MitchellStride/Libraries/KiCAD/µ104_Part_Libs/KiCAD_3D_Parts/SMD_Caps/CAP0805.stp

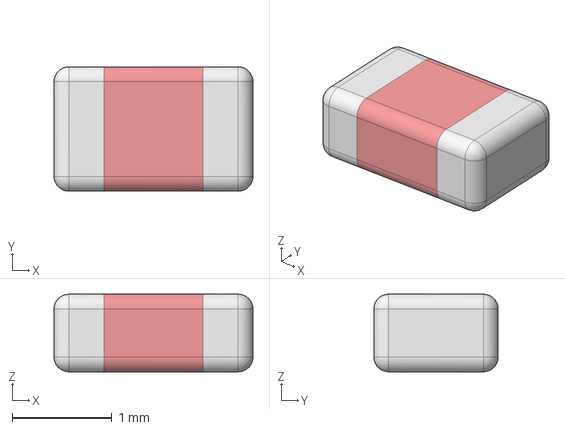
[picture p1: CAD file, 2018-05-30, last stored version]
KiCAD/µ104_Part_Libs/KiCAD_3D_Parts/SMD_Caps/CAP0805.stp
2.00 x 1.25 x 0.78 mm
