MitchellStride/Libraries/KiCAD/µ104_Part_Libs/KiCAD_3D_Parts/µ104KiCAD_3D/Laird-BMI-S-203-F  AND  BMI-S-203-C.step

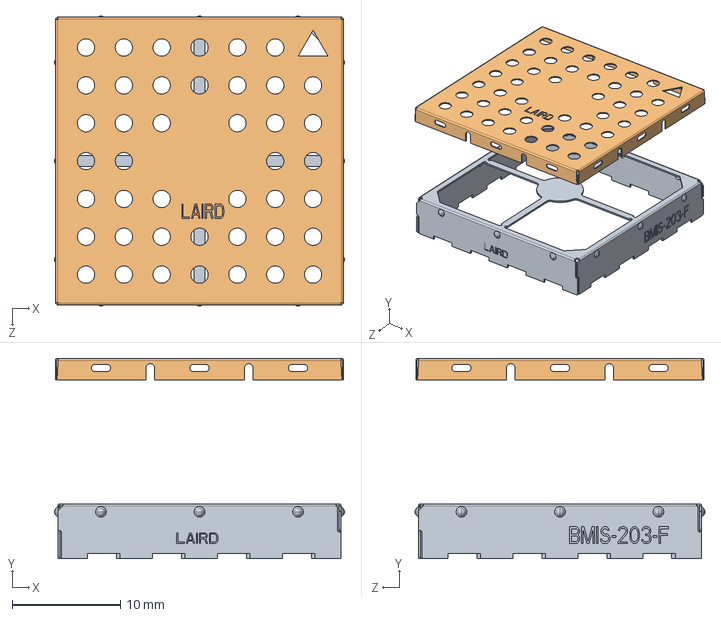
[picture p3: CAD file, 2018-05-30, last stored version]
KiCAD/µ104_Part_Libs/KiCAD_3D_Parts/µ104KiCAD_3D/Laird-BMI-S-203-F AND BMI-S-203-C.step
26.8 x 18.5 x 26.8 mm
Laird-BMI-S-203-F and BMI-S-203-C_BMI-S-203-F
Laird-BMI-S-203-F and BMI-S-203-C_BMI-S-203-C
