MitchellStride/Libraries/KiCAD/µ104_Part_Libs/KiCAD_3D_Parts/µ104KiCAD_connectors_3D/FCI_Minitek_98464-xxx-08xLF.step

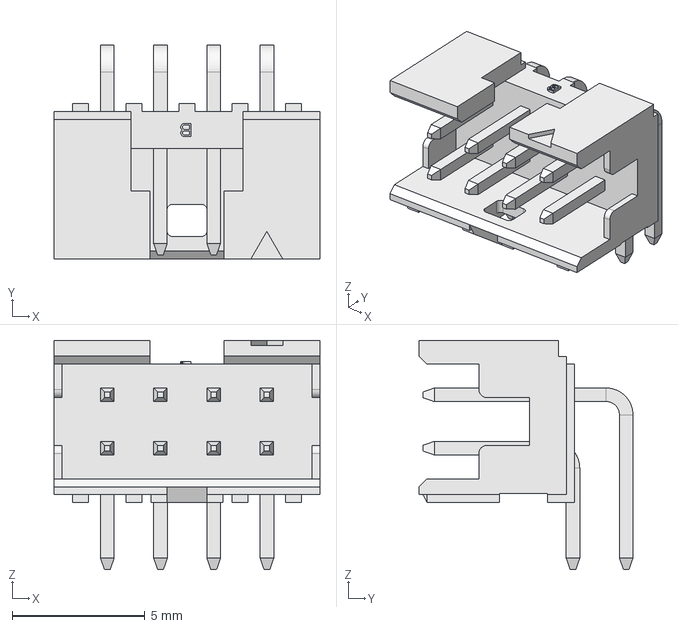
[picture p4: CAD file, 2018-05-30, last stored version]
KiCAD/µ104_Part_Libs/KiCAD_3D_Parts/µ104KiCAD_connectors_3D/FCI_Minitek_98464-xxx-08xLF.step
10.0 x 8.04 x 8.62 mm
