MitchellStride/Libraries/KiCAD/µ104_Part_Libs/KiCAD_3D_Parts/µ104KiCAD_DCDC_3D/VICOR_CHIP3623.STEP

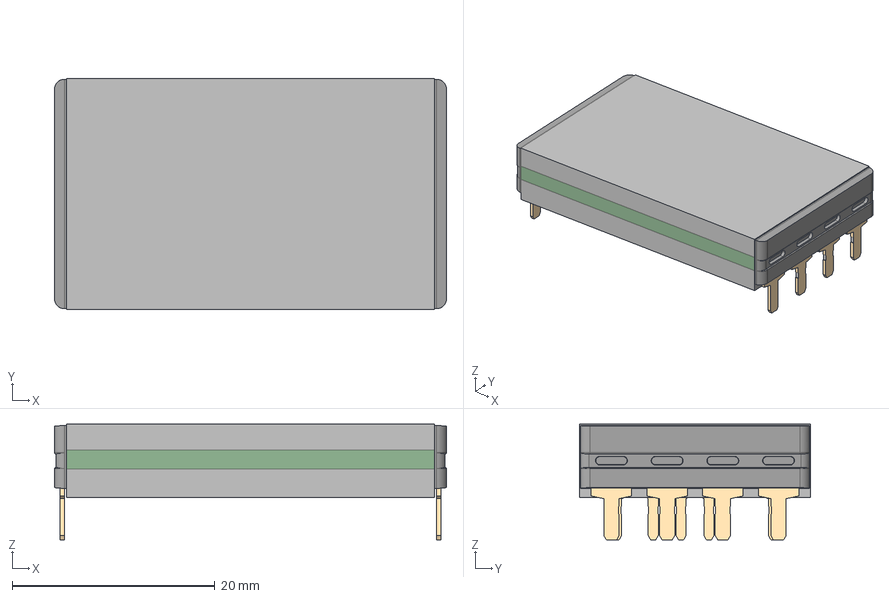
[picture p5: CAD file, 2018-05-30, last stored version]
KiCAD/µ104_Part_Libs/KiCAD_3D_Parts/µ104KiCAD_DCDC_3D/VICOR_CHIP3623.STEP
38.7 x 22.8 x 11.4 mm
