MitchellStride/Libraries/KiCAD/µ104_Part_Libs/KiCAD_3D_Parts/µ104KiCAD_IC_3D/SOD-323.step

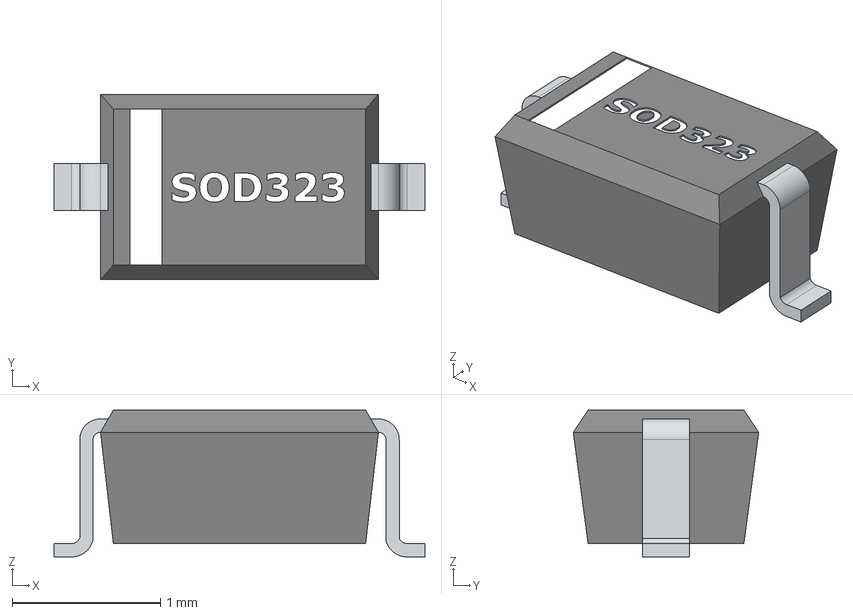
[picture p6: CAD file, 2018-05-30, last stored version]
KiCAD/µ104_Part_Libs/KiCAD_3D_Parts/µ104KiCAD_IC_3D/SOD-323.step
2.50 x 1.25 x 0.99 mm
