MitchellStride/Libraries/KiCAD/µ104_Part_Libs/KiCAD_3D_Parts/µ104KiCAD_relay_3D/Power_DPST_BB_ThruHole_Omron_G6B.step

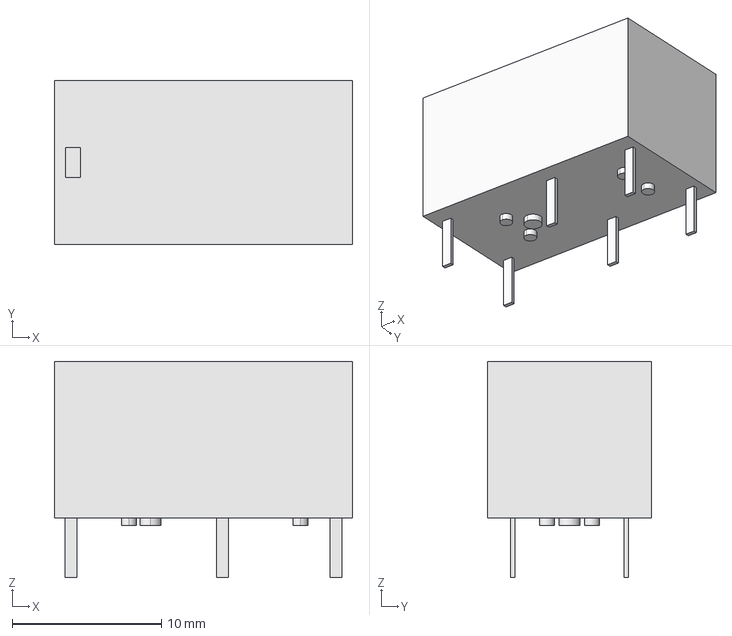
[picture p7: CAD file, 2018-05-30, last stored version]
KiCAD/µ104_Part_Libs/KiCAD_3D_Parts/µ104KiCAD_relay_3D/Power_DPST_BB_ThruHole_Omron_G6B.step
20.0 x 11.0 x 14.5 mm
