MitchellStride/Libraries/KiCAD/µ104_Part_Libs/KiCAD_3D_Parts/µ104KiCAD_RLC_3D/C_Panasonic_EEU-FM-A_D16_H25.step

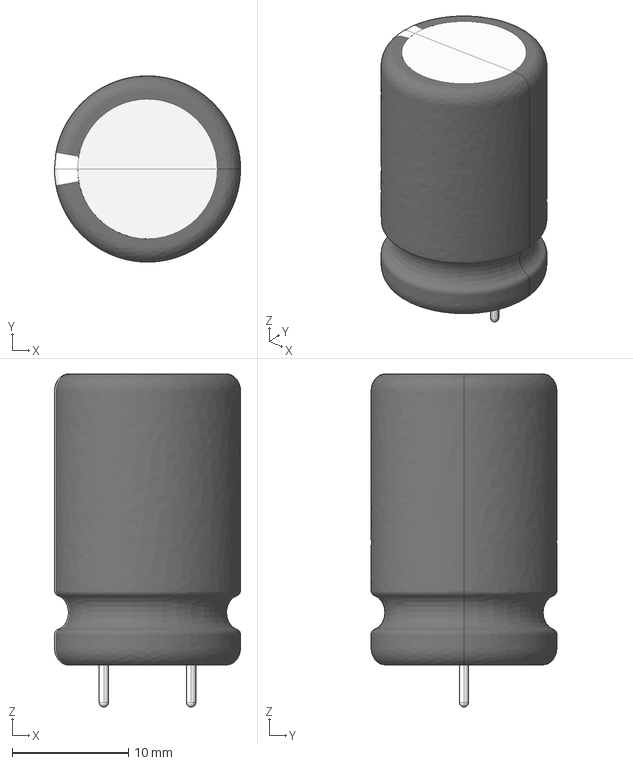
[picture p8: CAD file, 2018-05-30, last stored version]
KiCAD/µ104_Part_Libs/KiCAD_3D_Parts/µ104KiCAD_RLC_3D/C_Panasonic_EEU-FM-A_D16_H25.step
16.0 x 16.0 x 28.6 mm
