MitchellStride/Libraries/KiCAD/µ104_Part_Libs/KiCAD_3D_Parts/SMD_Caps/CAP1206.stp

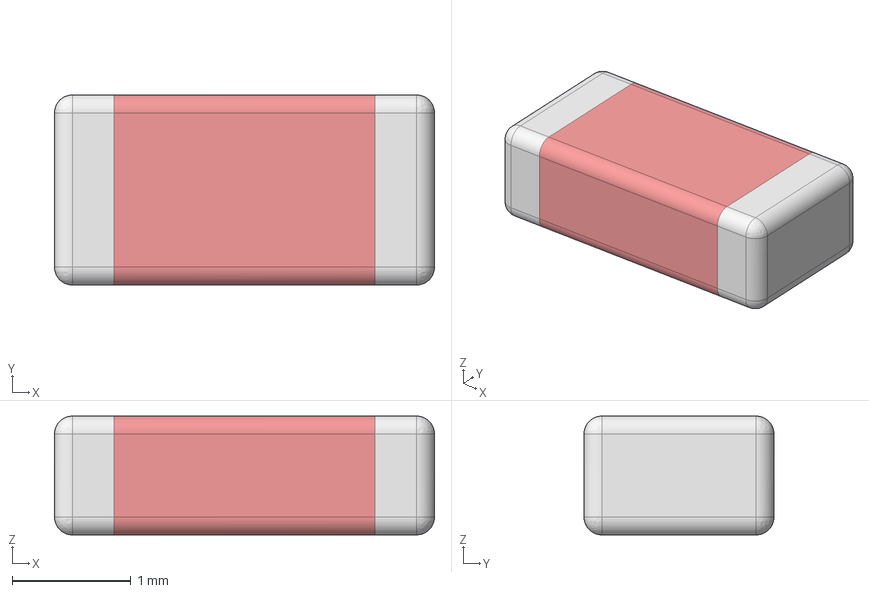
[picture p9: CAD file, 2018-05-30, last stored version]
KiCAD/µ104_Part_Libs/KiCAD_3D_Parts/SMD_Caps/CAP1206.stp
3.20 x 1.60 x 1.00 mm
