MitchellStride/Libraries/KiCAD/µ104_Part_Libs/KiCAD_3D_Parts/SMD_Resistors/RES1218.stp

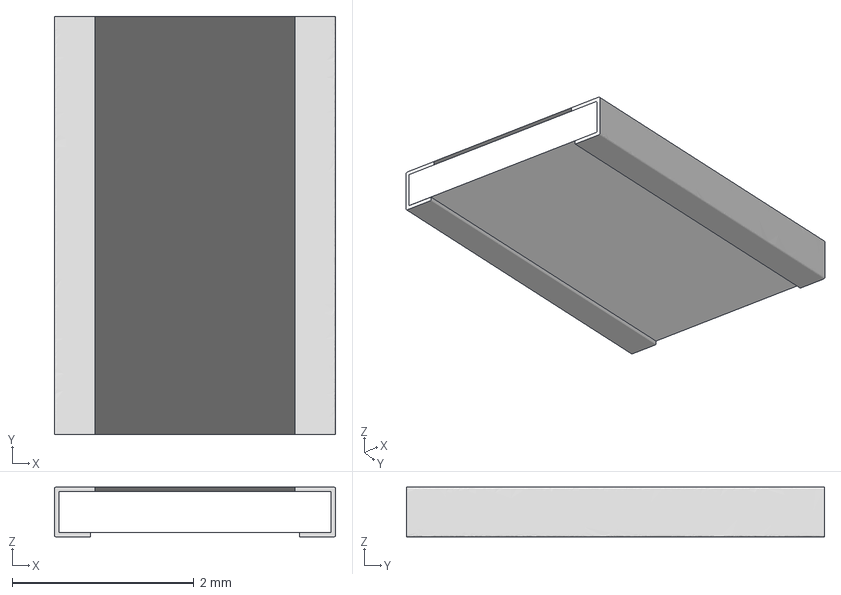
[picture p10: CAD file, 2018-05-30, last stored version]
KiCAD/µ104_Part_Libs/KiCAD_3D_Parts/SMD_Resistors/RES1218.stp
3.10 x 4.61 x 0.55 mm
