MitchellStride/Libraries/KiCAD/µ104_Part_Libs/KiCAD_3D_Parts/µ104KiCAD_3D/SHIELD_Laird_BMI-S-201-F.step

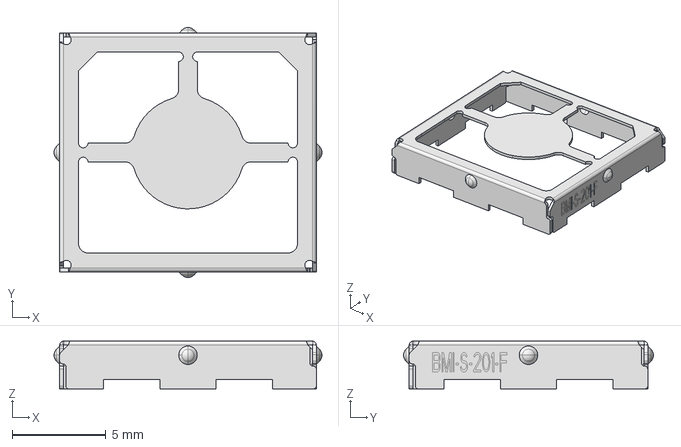
[picture p11: CAD file, 2018-05-30, last stored version]
KiCAD/µ104_Part_Libs/KiCAD_3D_Parts/µ104KiCAD_3D/SHIELD_Laird_BMI-S-201-F.step
14.3 x 13.3 x 2.54 mm
