MitchellStride/Libraries/KiCAD/µ104_Part_Libs/KiCAD_3D_Parts/µ104KiCAD_connectors_3D/Samtec_MTLW-106-07-L-S-280.step

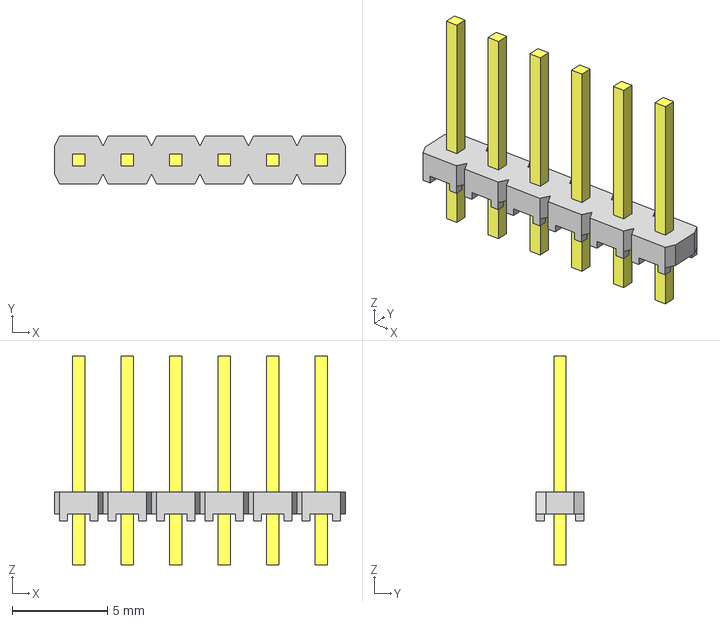
[picture p12: CAD file, 2018-05-30, last stored version]
KiCAD/µ104_Part_Libs/KiCAD_3D_Parts/µ104KiCAD_connectors_3D/Samtec_MTLW-106-07-L-S-280.step
15.2 x 2.49 x 10.9 mm
