MitchellStride/Libraries/KiCAD/µ104_Part_Libs/KiCAD_3D_Parts/µ104KiCAD_DCDC_3D/Murata_OKI-78SR_RA.STEP

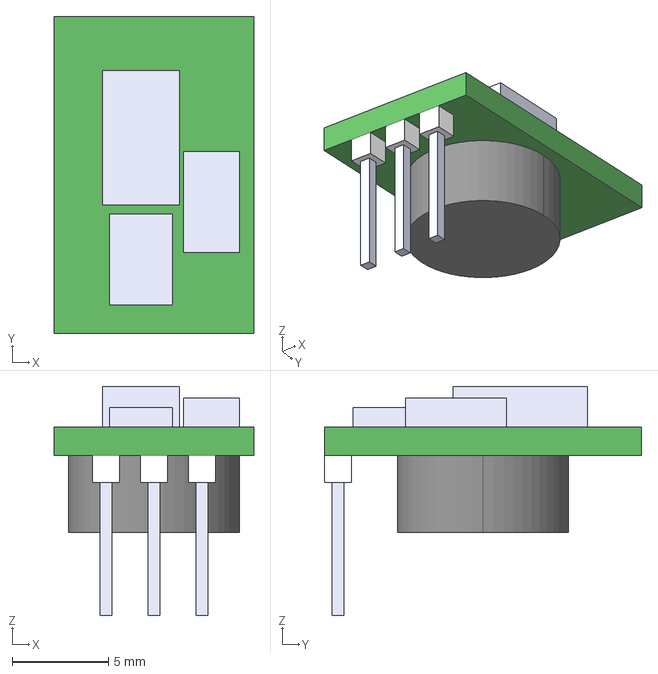
[picture p13: CAD file, 2018-05-30, last stored version]
KiCAD/µ104_Part_Libs/KiCAD_3D_Parts/µ104KiCAD_DCDC_3D/Murata_OKI-78SR_RA.STEP
10.4 x 16.5 x 11.9 mm
