MitchellStride/Libraries/KiCAD/µ104_Part_Libs/KiCAD_3D_Parts/µ104KiCAD_IC_3D/Crystal_L5_W3.2.step

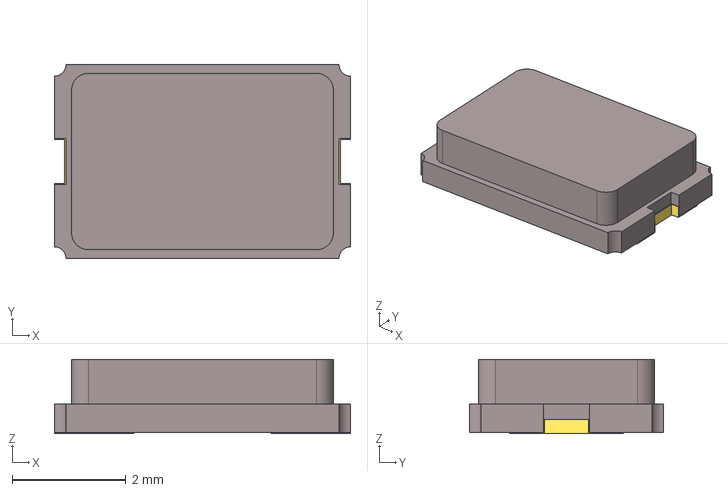
[picture p14: CAD file, 2018-05-30, last stored version]
KiCAD/µ104_Part_Libs/KiCAD_3D_Parts/µ104KiCAD_IC_3D/Crystal_L5_W3.2.step
5.20 x 3.40 x 1.30 mm
