MitchellStride/Libraries/KiCAD/µ104_Part_Libs/KiCAD_3D_Parts/µ104KiCAD_relay_3D/Telecom_DPDT_CC_GullWing_Panasonic_TQ-SMD.step

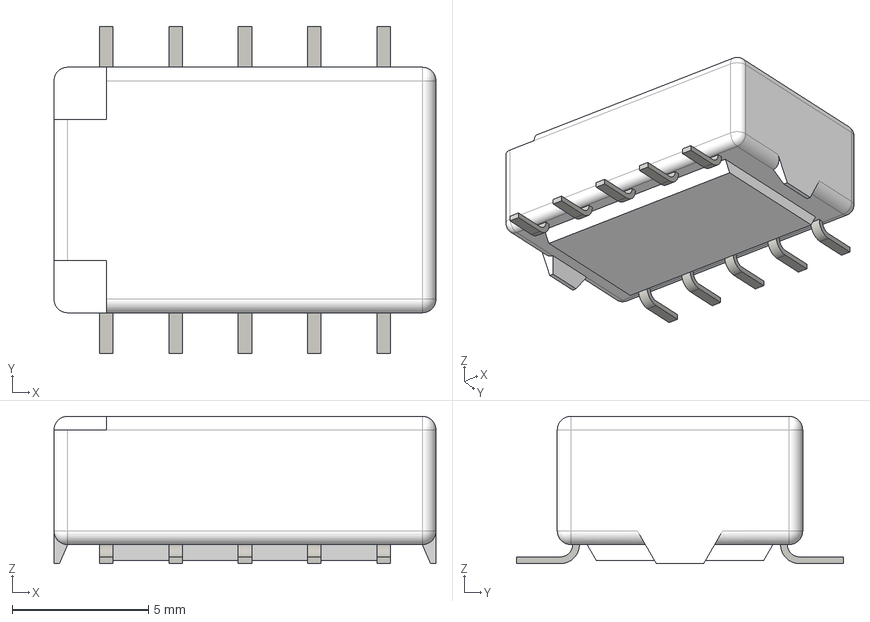
[picture p15: CAD file, 2018-05-30, last stored version]
KiCAD/µ104_Part_Libs/KiCAD_3D_Parts/µ104KiCAD_relay_3D/Telecom_DPDT_CC_GullWing_Panasonic_TQ-SMD.step
14.0 x 12.0 x 5.40 mm
