MitchellStride/Libraries/KiCAD/µ104_Part_Libs/KiCAD_3D_Parts/µ104KiCAD_RLC_3D/C_CDE_SLPX_D35_H35.step

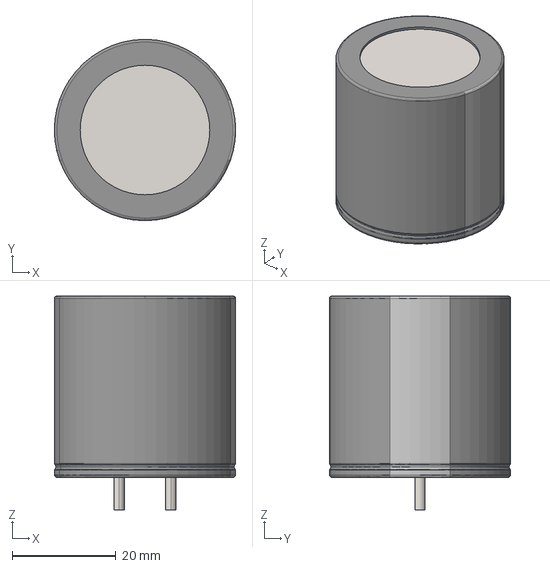
[picture p16: CAD file, 2018-05-30, last stored version]
KiCAD/µ104_Part_Libs/KiCAD_3D_Parts/µ104KiCAD_RLC_3D/C_CDE_SLPX_D35_H35.step
35.0 x 35.0 x 41.3 mm
