MitchellStride/Libraries/KiCAD/µ104_Part_Libs/KiCAD_3D_Parts/SMD_Caps/CAP2220.stp

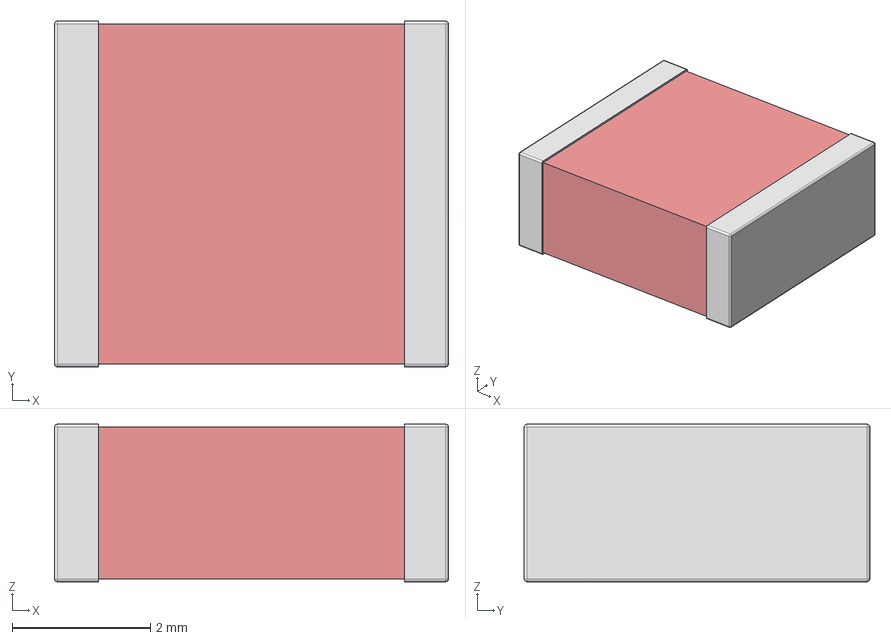
[picture p17: CAD file, 2018-05-30, last stored version]
KiCAD/µ104_Part_Libs/KiCAD_3D_Parts/SMD_Caps/CAP2220.stp
5.70 x 5.00 x 2.28 mm
