MitchellStride/Libraries/KiCAD/µ104_Part_Libs/KiCAD_3D_Parts/SMD_Resistors/RES2010.stp

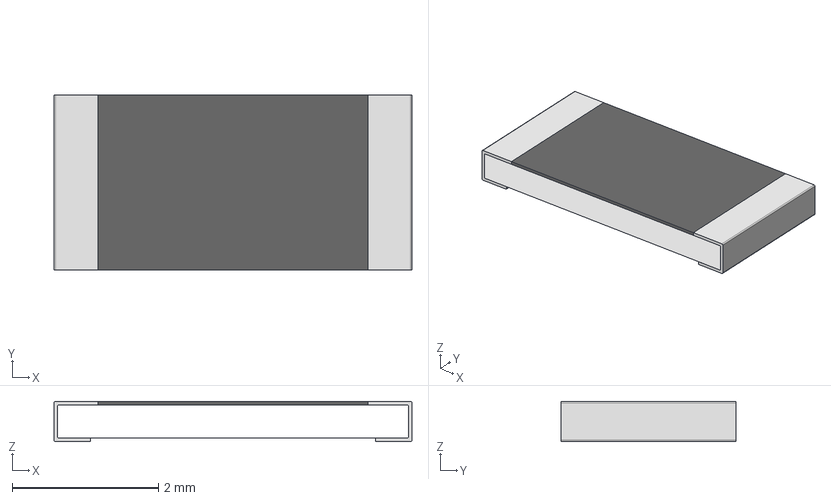
[picture p18: CAD file, 2018-05-30, last stored version]
KiCAD/µ104_Part_Libs/KiCAD_3D_Parts/SMD_Resistors/RES2010.stp
4.90 x 2.40 x 0.55 mm
