MitchellStride/Libraries/KiCAD/µ104_Part_Libs/KiCAD_3D_Parts/µ104KiCAD_3D/SHIELD_Laird-BMI-S-203-F.step

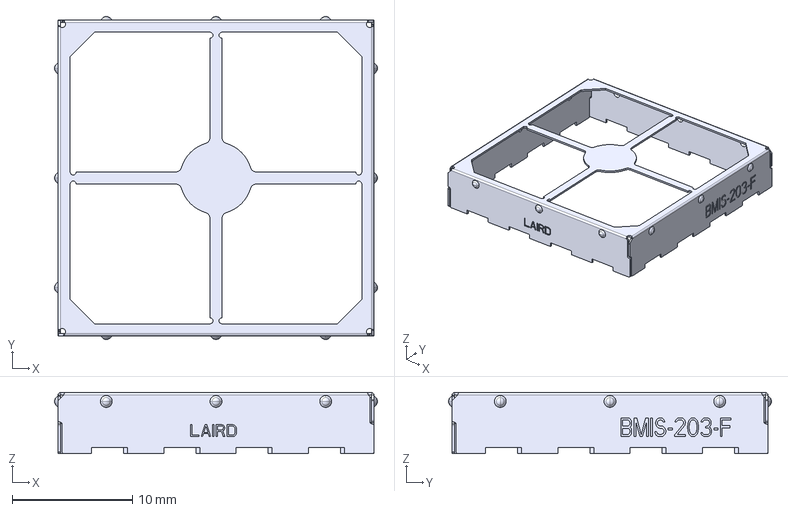
[picture p19: CAD file, 2018-05-30, last stored version]
KiCAD/µ104_Part_Libs/KiCAD_3D_Parts/µ104KiCAD_3D/SHIELD_Laird-BMI-S-203-F.step
26.8 x 26.8 x 5.08 mm
