MitchellStride/Libraries/KiCAD/µ104_Part_Libs/KiCAD_3D_Parts/µ104KiCAD_DCDC_3D/VICOR_VTM.step

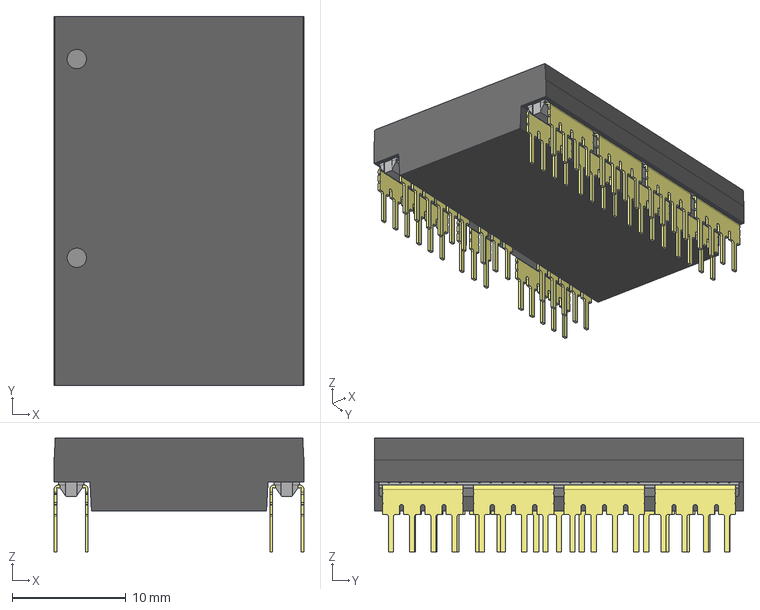
[picture p21: CAD file, 2018-05-30, last stored version]
KiCAD/µ104_Part_Libs/KiCAD_3D_Parts/µ104KiCAD_DCDC_3D/VICOR_VTM.step
22.0 x 32.5 x 10.0 mm
