MitchellStride/Libraries/KiCAD/µ104_Part_Libs/KiCAD_3D_Parts/µ104KiCAD_IC_3D/TO-252-3.step

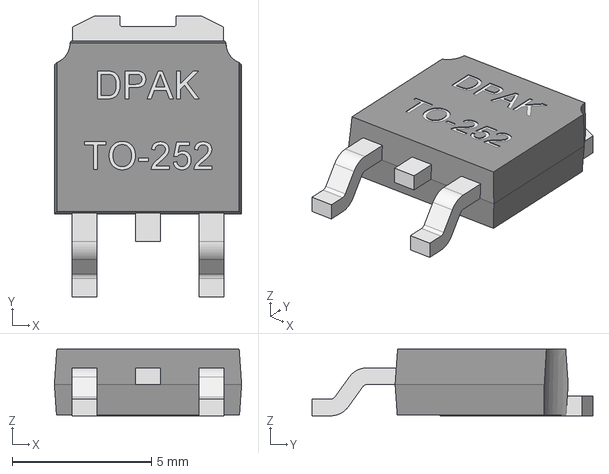
[picture p22: CAD file, 2018-05-30, last stored version]
KiCAD/µ104_Part_Libs/KiCAD_3D_Parts/µ104KiCAD_IC_3D/TO-252-3.step
6.73 x 10.1 x 2.40 mm
