MitchellStride/Libraries/KiCAD/µ104_Part_Libs/KiCAD_3D_Parts/µ104KiCAD_relay_3D/Telecom_DPDT_CC_ThruHole_Omron_G6K.step

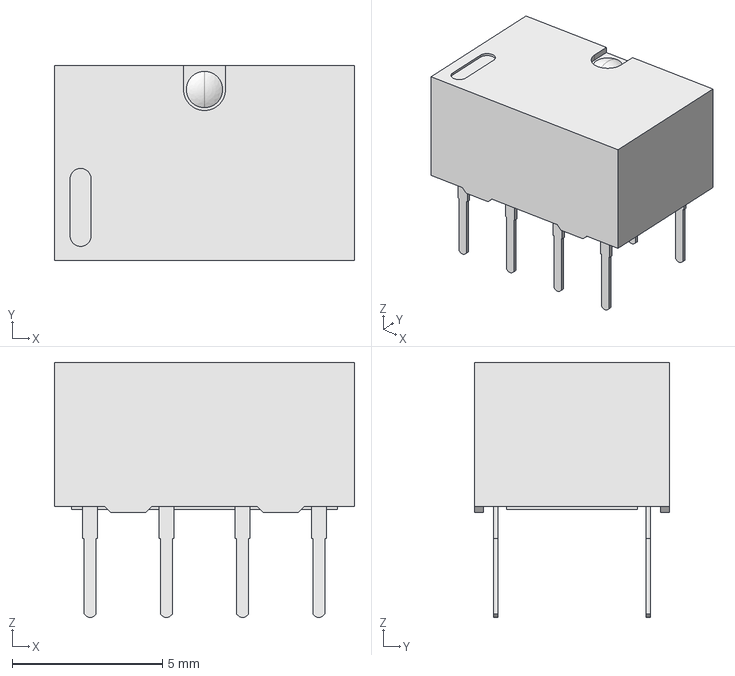
[picture p23: CAD file, 2018-05-30, last stored version]
KiCAD/µ104_Part_Libs/KiCAD_3D_Parts/µ104KiCAD_relay_3D/Telecom_DPDT_CC_ThruHole_Omron_G6K.step
10.0 x 6.50 x 8.50 mm
