MitchellStride/Libraries/KiCAD/µ104_Part_Libs/KiCAD_3D_Parts/µ104KiCAD_RLC_3D/F_BelFuse_Type0697H.STEP

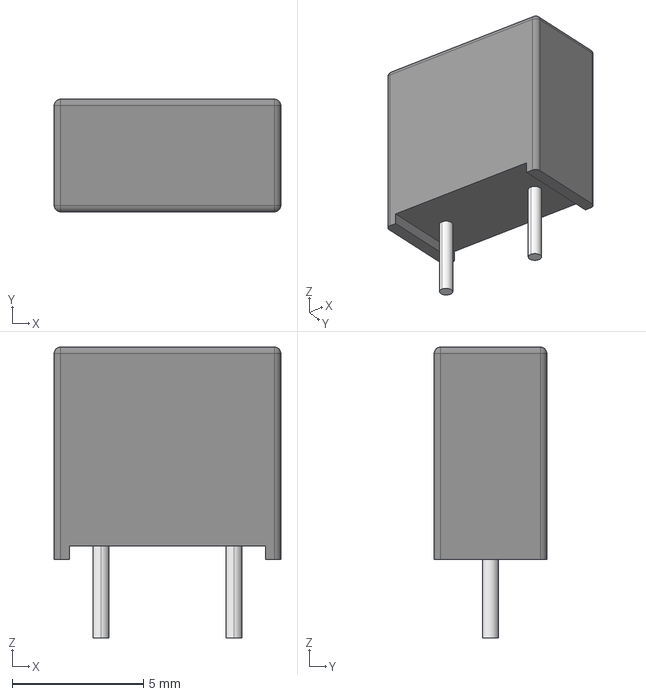
[picture p24: CAD file, 2018-05-30, last stored version]
KiCAD/µ104_Part_Libs/KiCAD_3D_Parts/µ104KiCAD_RLC_3D/F_BelFuse_Type0697H.STEP
8.65 x 4.30 x 11.1 mm
