MitchellStride/Libraries/KiCAD/µ104_Part_Libs/KiCAD_3D_Parts/SMD_Caps/CAP2225.stp

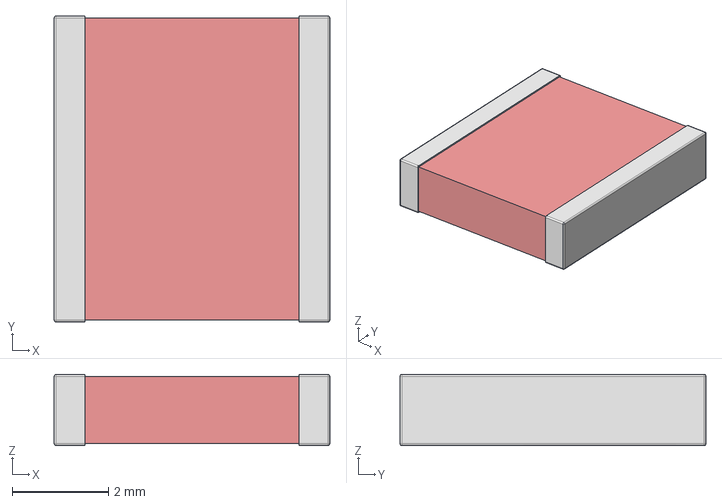
[picture p25: CAD file, 2018-05-30, last stored version]
KiCAD/µ104_Part_Libs/KiCAD_3D_Parts/SMD_Caps/CAP2225.stp
5.72 x 6.35 x 1.48 mm
