MitchellStride/Libraries/KiCAD/µ104_Part_Libs/KiCAD_3D_Parts/SMD_Resistors/RES0603.stp

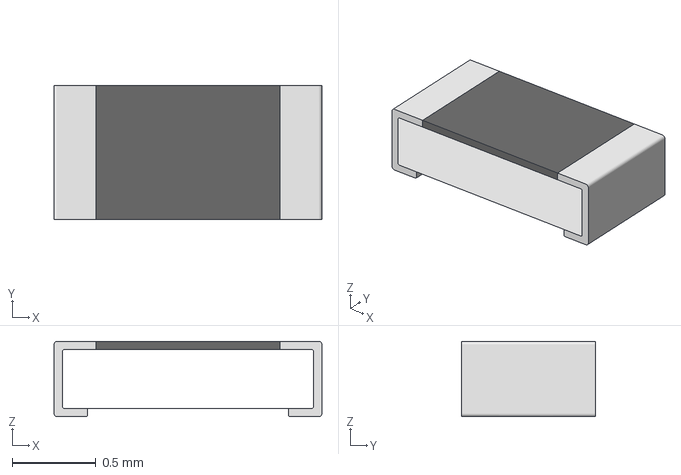
[picture p26: CAD file, 2018-05-30, last stored version]
KiCAD/µ104_Part_Libs/KiCAD_3D_Parts/SMD_Resistors/RES0603.stp
1.60 x 0.8 x 0.45 mm
