MitchellStride/Libraries/KiCAD/µ104_Part_Libs/KiCAD_3D_Parts/µ104KiCAD_3D/Laird-BMI-S-201-F  AND  BMI-S-201-C.step

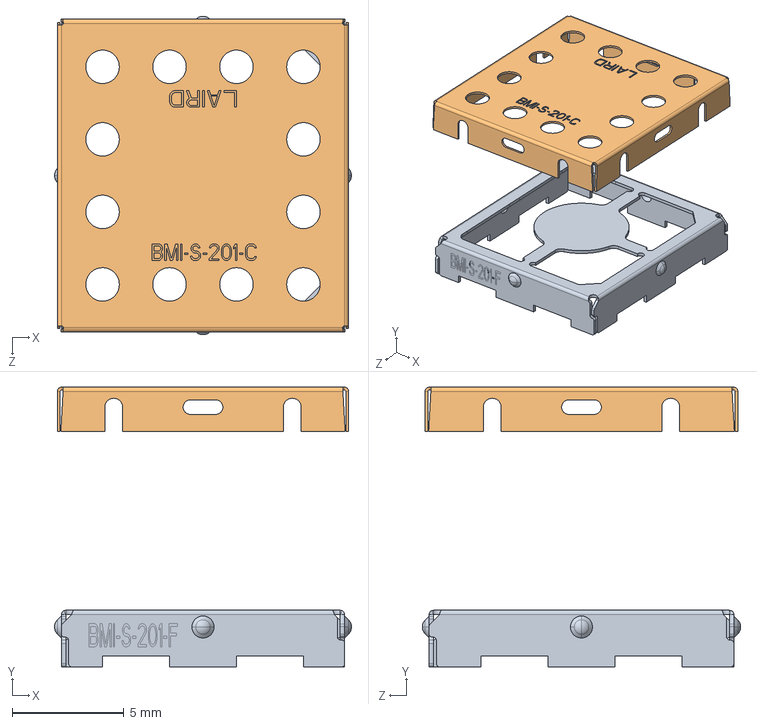
[picture p27: CAD file, 2018-05-30, last stored version]
KiCAD/µ104_Part_Libs/KiCAD_3D_Parts/µ104KiCAD_3D/Laird-BMI-S-201-F AND BMI-S-201-C.step
13.3 x 12.5 x 14.3 mm
Laird-$PARTNUMBER_Laird-BMI-S-201-F and BMI-S-201-C_BMI-S-201-F
Laird-$PARTNUMBER_Laird-BMI-S-201-F and BMI-S-201-C_BMI-S-201-C
