MitchellStride/Libraries/KiCAD/µ104_Part_Libs/KiCAD_3D_Parts/µ104KiCAD_connectors_3D/Molex_Micro-Fit3_0-43650-0415.step

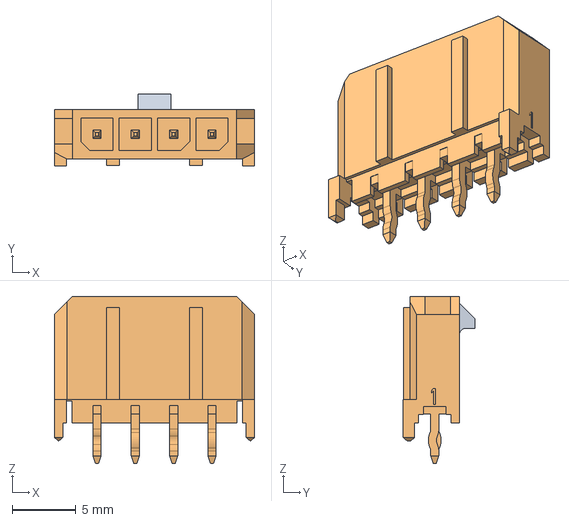
[picture p28: CAD file, 2018-05-30, last stored version]
KiCAD/µ104_Part_Libs/KiCAD_3D_Parts/µ104KiCAD_connectors_3D/Molex_Micro-Fit3_0-43650-0415.step
15.7 x 5.61 x 13.1 mm
