MitchellStride/Libraries/KiCAD/µ104_Part_Libs/KiCAD_3D_Parts/µ104KiCAD_DCDC_3D/CUI_P7805.step

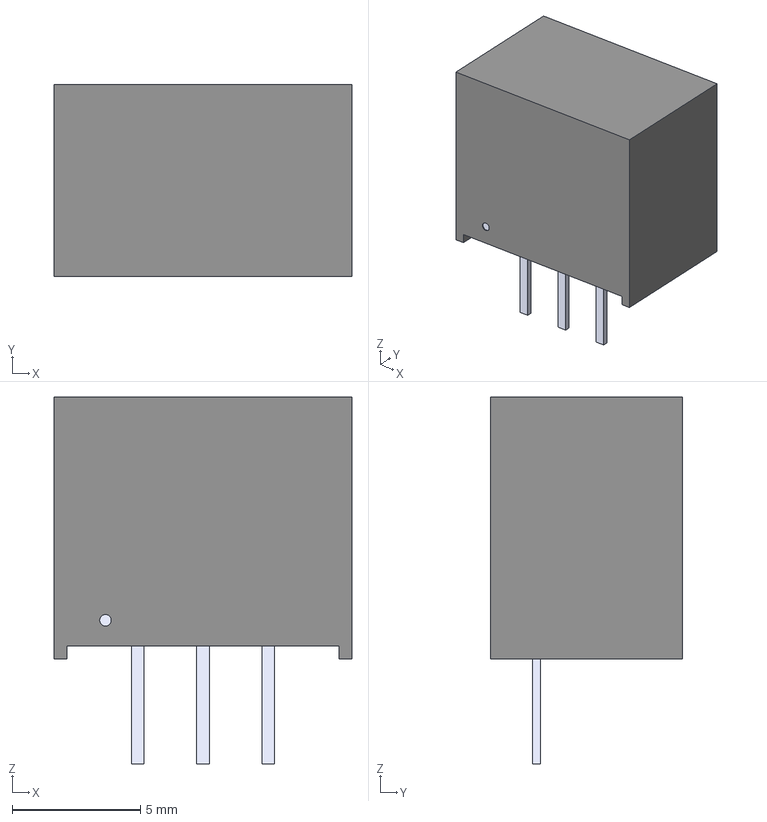
[picture p29: CAD file, 2018-05-30, last stored version]
KiCAD/µ104_Part_Libs/KiCAD_3D_Parts/µ104KiCAD_DCDC_3D/CUI_P7805.step
11.6 x 7.50 x 14.3 mm
