MitchellStride/Libraries/KiCAD/µ104_Part_Libs/KiCAD_3D_Parts/µ104KiCAD_IC_3D/DIP-14-8.STEP

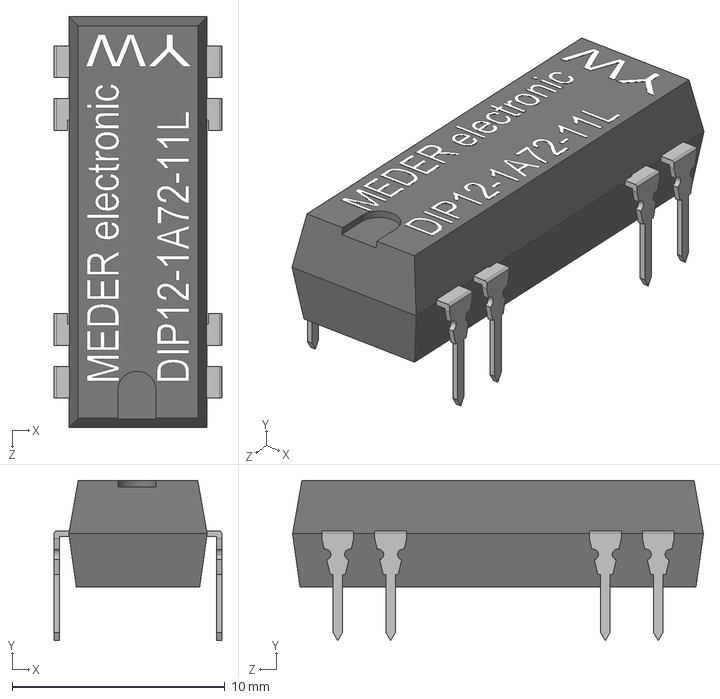
[picture p30: CAD file, 2018-05-30, last stored version]
KiCAD/µ104_Part_Libs/KiCAD_3D_Parts/µ104KiCAD_IC_3D/DIP-14-8.STEP
7.87 x 7.54 x 19.3 mm
