MitchellStride/Libraries/KiCAD/µ104_Part_Libs/KiCAD_3D_Parts/µ104KiCAD_relay_3D/Telecom_DPDT_CC_GullWing_Omron_G6K.step

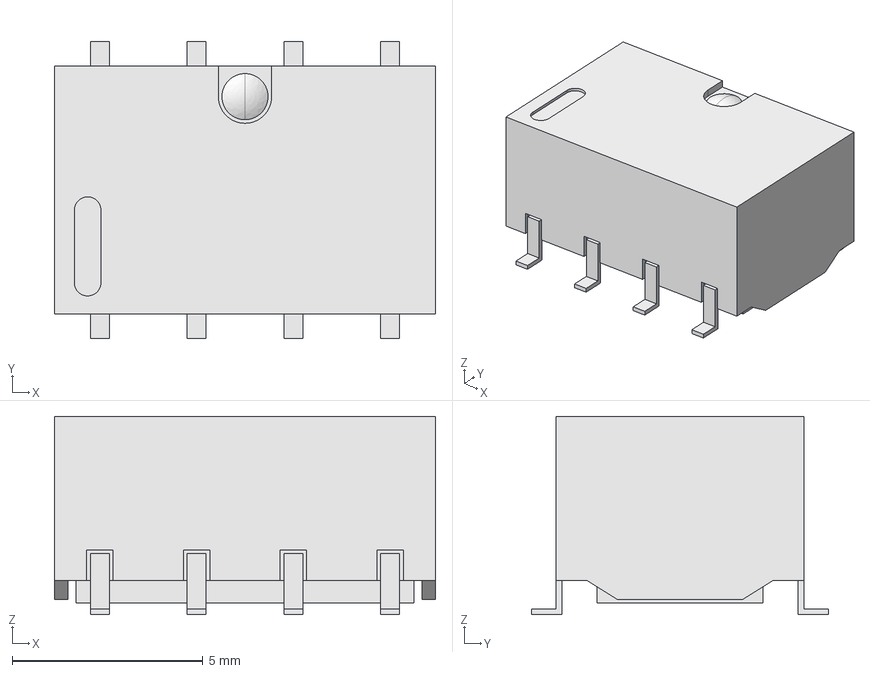
[picture p31: CAD file, 2018-05-30, last stored version]
KiCAD/µ104_Part_Libs/KiCAD_3D_Parts/µ104KiCAD_relay_3D/Telecom_DPDT_CC_GullWing_Omron_G6K.step
10.0 x 7.80 x 5.20 mm
