MitchellStride/Libraries/KiCAD/µ104_Part_Libs/KiCAD_3D_Parts/µ104KiCAD_RLC_3D/L_Vishay_IHLP3232CZ.step

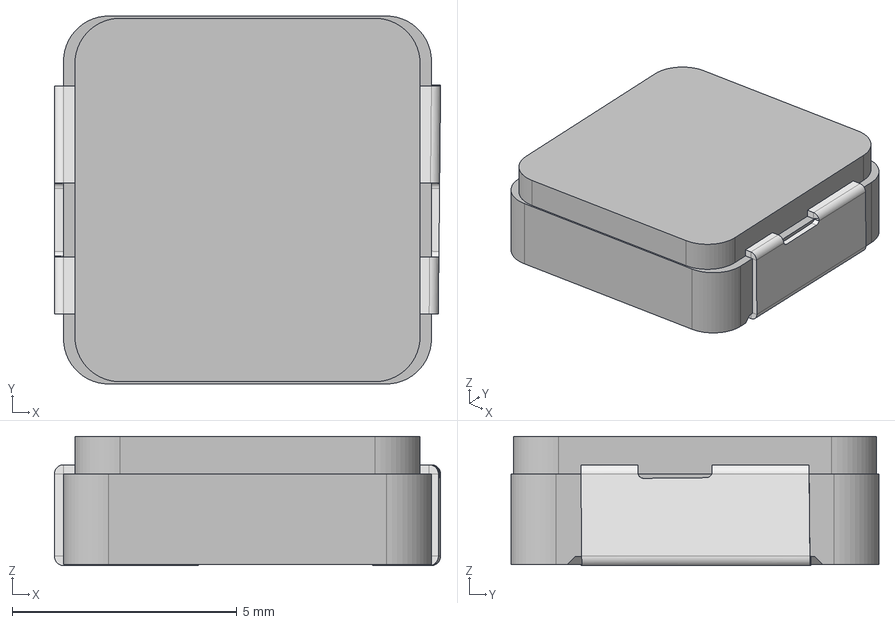
[picture p32: CAD file, 2018-05-30, last stored version]
KiCAD/µ104_Part_Libs/KiCAD_3D_Parts/µ104KiCAD_RLC_3D/L_Vishay_IHLP3232CZ.step
8.60 x 8.19 x 2.88 mm
