MitchellStride/Libraries/KiCAD/µ104_Part_Libs/KiCAD_3D_Parts/SMD_Caps/CAP1812.stp

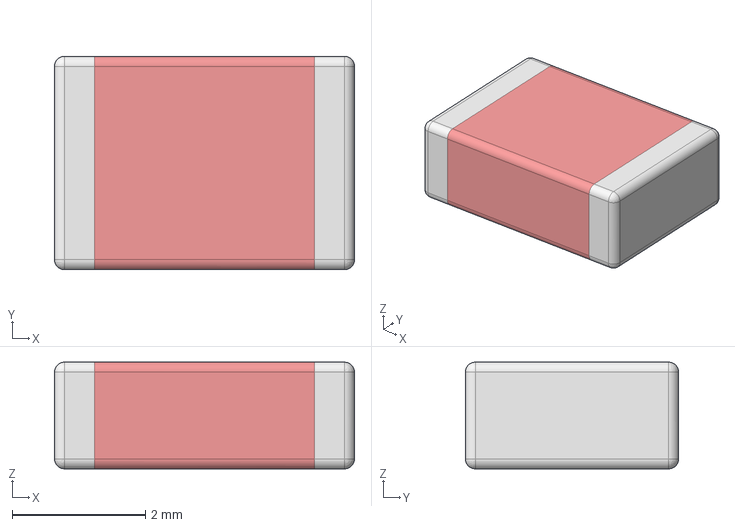
[picture p33: CAD file, 2018-05-30, last stored version]
KiCAD/µ104_Part_Libs/KiCAD_3D_Parts/SMD_Caps/CAP1812.stp
4.50 x 3.20 x 1.60 mm
