MitchellStride/Libraries/KiCAD/µ104_Part_Libs/KiCAD_3D_Parts/SMD_Resistors/RES0402.stp

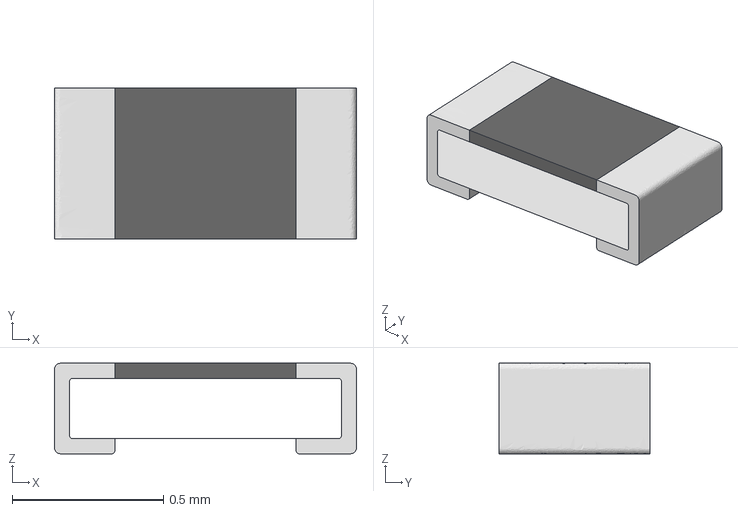
[picture p34: CAD file, 2018-05-30, last stored version]
KiCAD/µ104_Part_Libs/KiCAD_3D_Parts/SMD_Resistors/RES0402.stp
1.00 x 0.5 x 0.3 mm
