MitchellStride/Libraries/KiCAD/µ104_Part_Libs/KiCAD_3D_Parts/µ104KiCAD_connectors_3D/FCI_Minitek_98414-xxx-08xLF.step

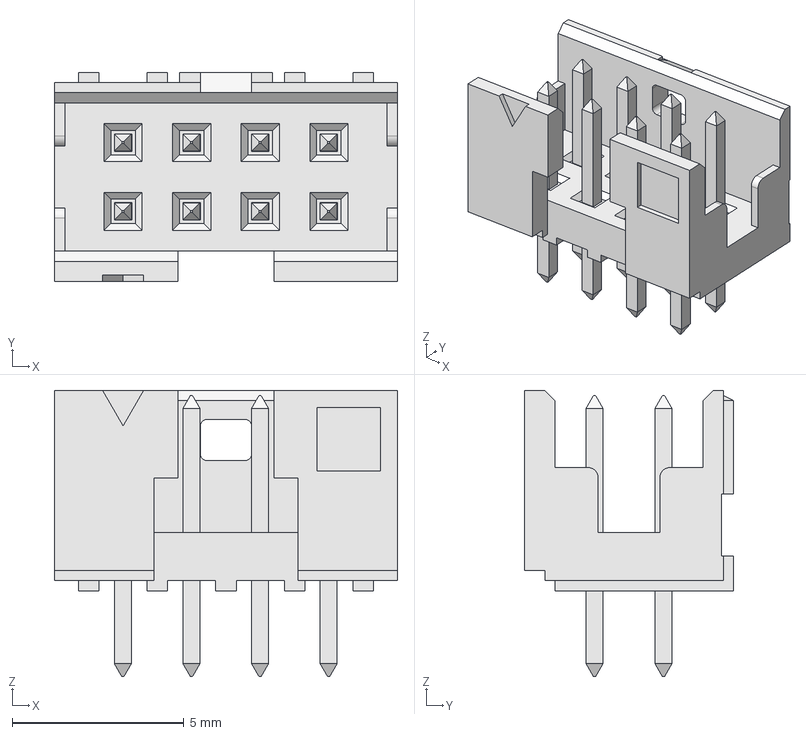
[picture p35: CAD file, 2018-05-30, last stored version]
KiCAD/µ104_Part_Libs/KiCAD_3D_Parts/µ104KiCAD_connectors_3D/FCI_Minitek_98414-xxx-08xLF.step
10.0 x 6.10 x 8.35 mm
