MitchellStride/Libraries/KiCAD/µ104_Part_Libs/KiCAD_3D_Parts/µ104KiCAD_DCDC_3D/VICOR_MINI.step

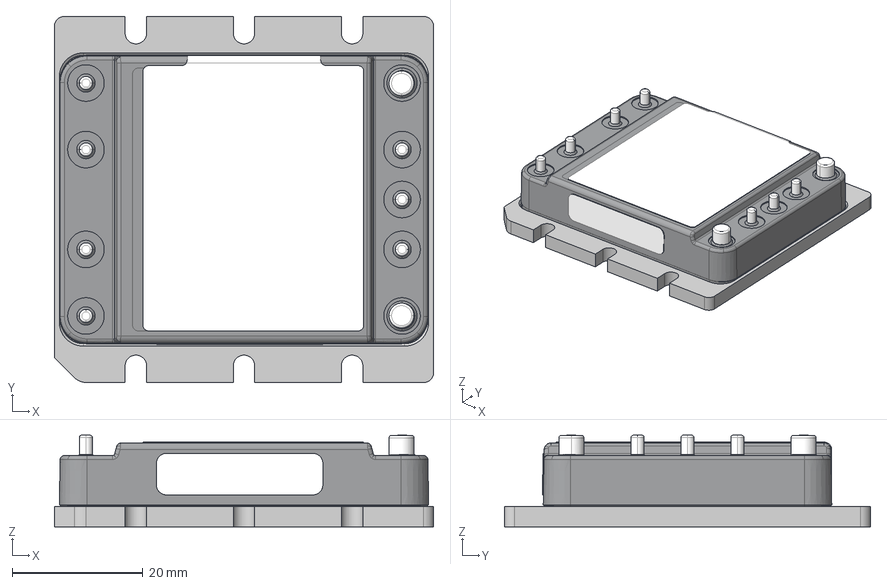
[picture p36: CAD file, 2018-05-30, last stored version]
KiCAD/µ104_Part_Libs/KiCAD_3D_Parts/µ104KiCAD_DCDC_3D/VICOR_MINI.step
58.1 x 56.0 x 14.0 mm
