MitchellStride/Libraries/KiCAD/µ104_Part_Libs/KiCAD_3D_Parts/µ104KiCAD_IC_3D/SSOP-16.step

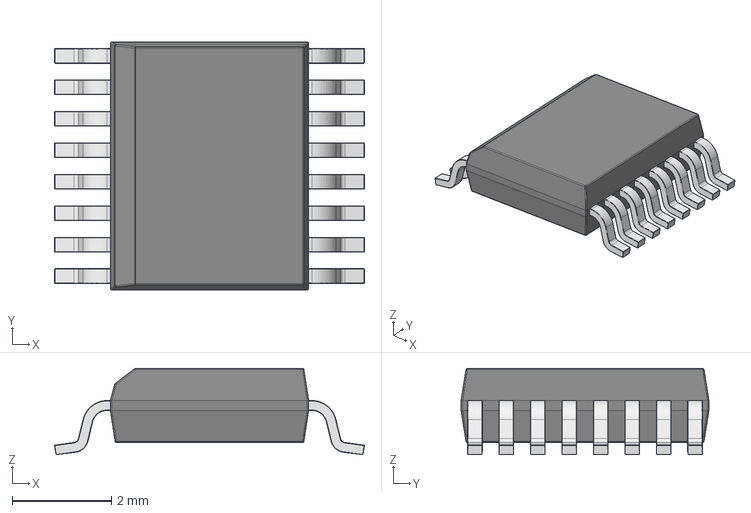
[picture p37: CAD file, 2018-05-30, last stored version]
KiCAD/µ104_Part_Libs/KiCAD_3D_Parts/µ104KiCAD_IC_3D/SSOP-16.step
6.25 x 5.00 x 1.74 mm
