MitchellStride/Libraries/KiCAD/µ104_Part_Libs/KiCAD_3D_Parts/µ104KiCAD_relay_3D/Telecom_DPDT_CC_GullWing_TEConnectivity_IM-AXICOM.step

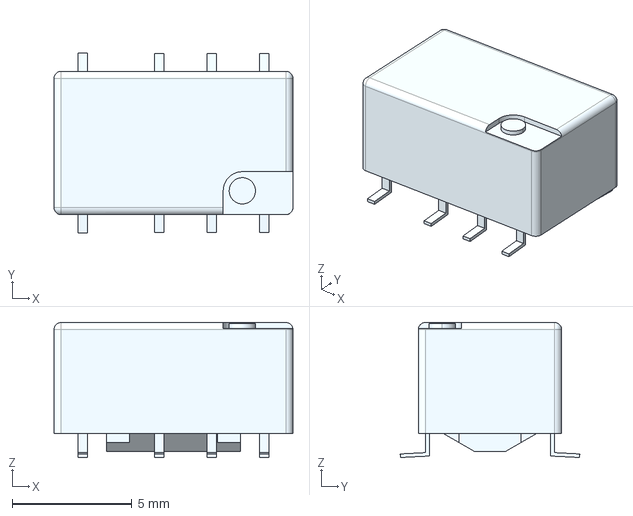
[picture p38: CAD file, 2018-05-30, last stored version]
KiCAD/µ104_Part_Libs/KiCAD_3D_Parts/µ104KiCAD_relay_3D/Telecom_DPDT_CC_GullWing_TEConnectivity_IM-AXICOM.step
10.0 x 7.52 x 5.65 mm
