MitchellStride/Libraries/KiCAD/µ104_Part_Libs/KiCAD_3D_Parts/µ104KiCAD_RLC_3D/LED_5mmThruHole.step

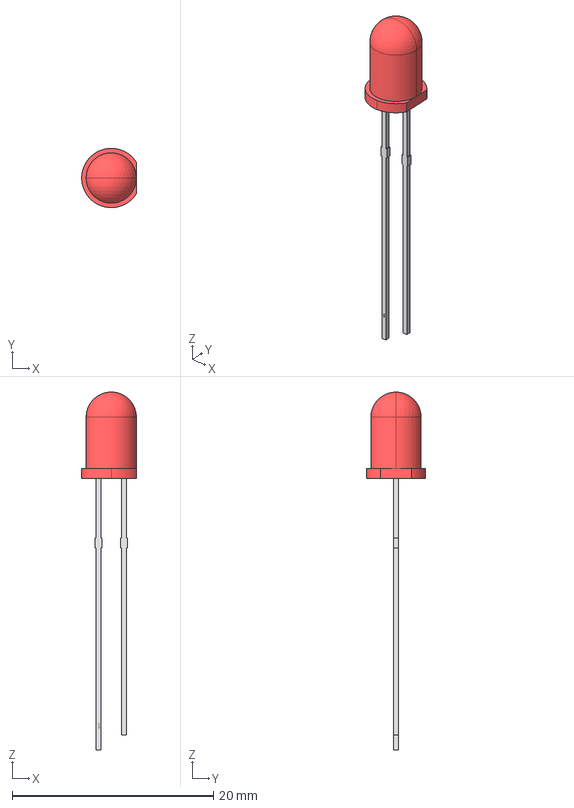
[picture p39: CAD file, 2018-05-30, last stored version]
KiCAD/µ104_Part_Libs/KiCAD_3D_Parts/µ104KiCAD_RLC_3D/LED_5mmThruHole.step
5.45 x 5.90 x 35.6 mm
