MitchellStride/Libraries/KiCAD/µ104_Part_Libs/KiCAD_3D_Parts/µ104KiCAD_connectors_3D/FCI_Minitek_98464-xxx-10xLF.step

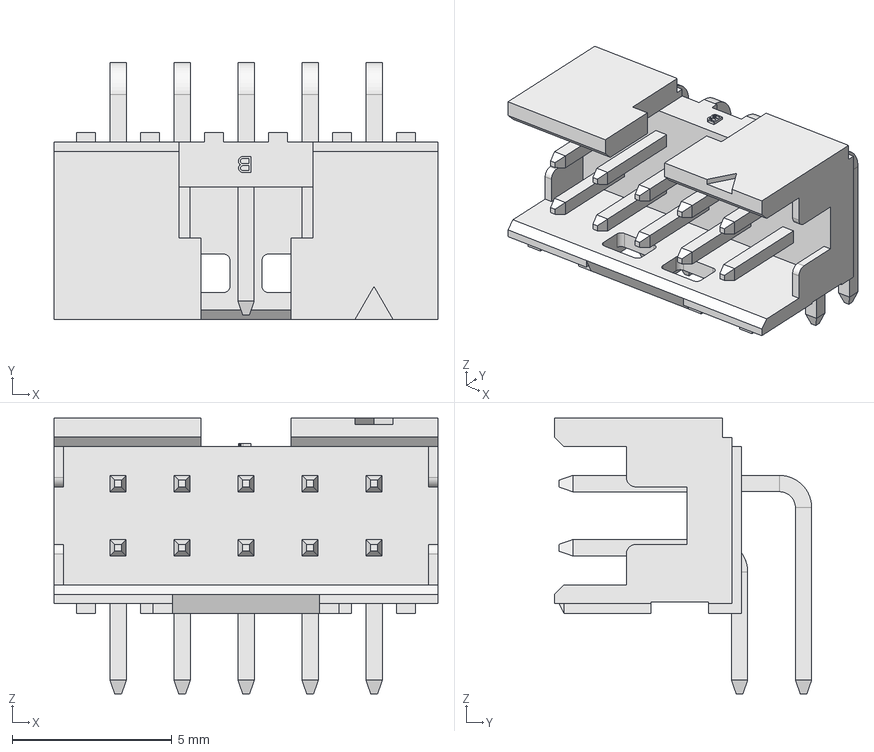
[picture p42: CAD file, 2018-05-30, last stored version]
KiCAD/µ104_Part_Libs/KiCAD_3D_Parts/µ104KiCAD_connectors_3D/FCI_Minitek_98464-xxx-10xLF.step
12.0 x 8.04 x 8.62 mm
