MitchellStride/Libraries/KiCAD/µ104_Part_Libs/KiCAD_3D_Parts/µ104KiCAD_IC_3D/PressureSensor_NXP_MPXHZ6115A6U.step

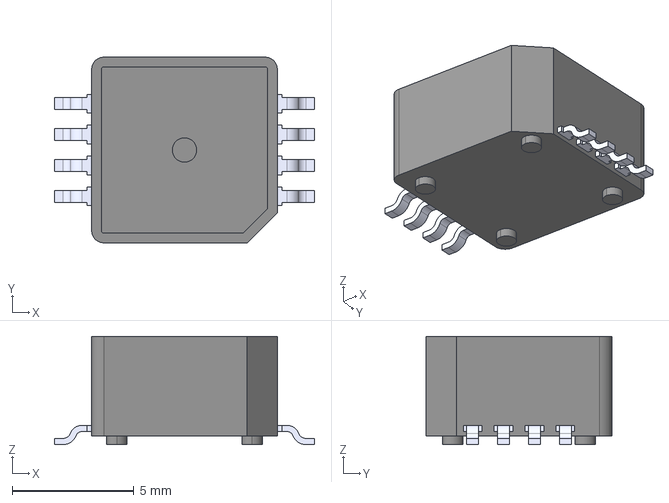
[picture p44: CAD file, 2018-05-30, last stored version]
KiCAD/µ104_Part_Libs/KiCAD_3D_Parts/µ104KiCAD_IC_3D/PressureSensor_NXP_MPXHZ6115A6U.step
10.7 x 7.62 x 4.45 mm
