MitchellStride/Libraries/KiCAD/µ104_Part_Libs/KiCAD_3D_Parts/µ104KiCAD_RLC_3D/LED_Wurth_WL-SMCW_0805.step

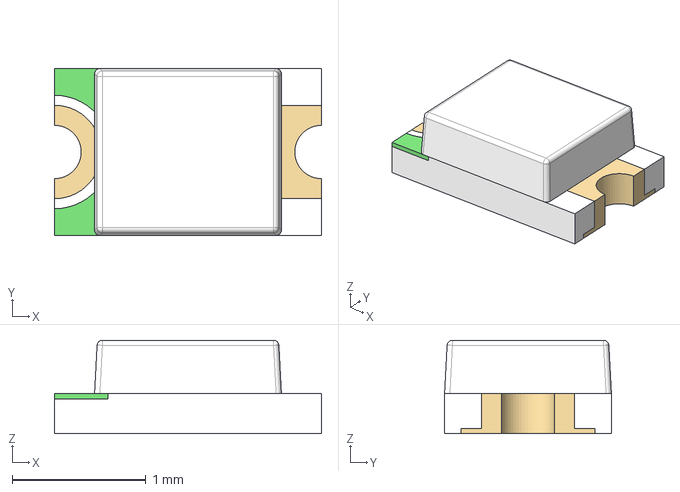
[picture p45: CAD file, 2018-05-30, last stored version]
KiCAD/µ104_Part_Libs/KiCAD_3D_Parts/µ104KiCAD_RLC_3D/LED_Wurth_WL-SMCW_0805.step
2.00 x 1.25 x 0.7 mm
