MitchellStride/Libraries/KiCAD/µ104_Part_Libs/KiCAD_3D_Parts/µ104KiCAD_IC_3D/TO-220-2_Horizontal.step

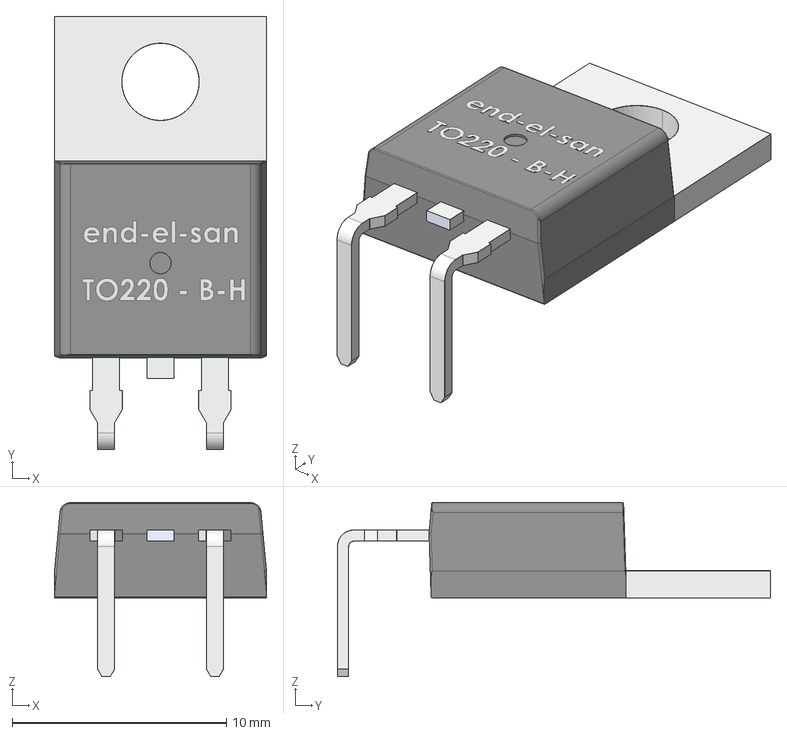
[picture p50: CAD file, 2018-05-30, last stored version]
KiCAD/µ104_Part_Libs/KiCAD_3D_Parts/µ104KiCAD_IC_3D/TO-220-2_Horizontal.step
9.90 x 20.2 x 8.13 mm
