MitchellStride/Libraries/KiCAD/µ104_Part_Libs/KiCAD_3D_Parts/µ104KiCAD_relay_3D/Reed_SPST_A_SIP-4_CotoTechnology_9000.step

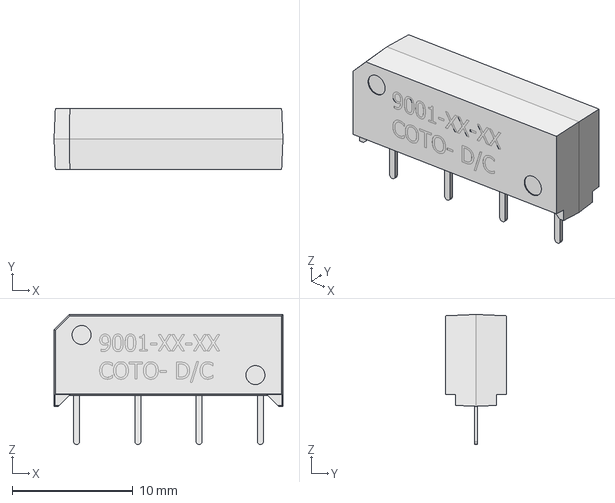
[picture p51: CAD file, 2018-05-30, last stored version]
KiCAD/µ104_Part_Libs/KiCAD_3D_Parts/µ104KiCAD_relay_3D/Reed_SPST_A_SIP-4_CotoTechnology_9000.step
19.0 x 5.03 x 10.8 mm
