MitchellStride/Libraries/KiCAD/µ104_Part_Libs/KiCAD_3D_Parts/µ104KiCAD_DCDC_3D/Recom_ECONOLINE-RxS.step

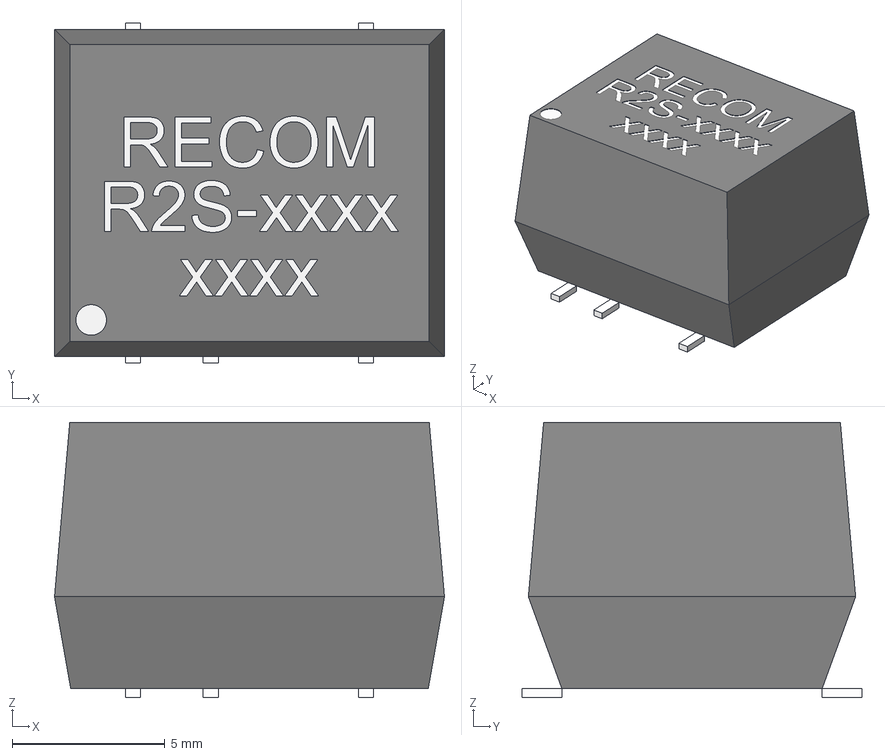
[picture p56: CAD file, 2018-05-30, last stored version]
KiCAD/µ104_Part_Libs/KiCAD_3D_Parts/µ104KiCAD_DCDC_3D/Recom_ECONOLINE-RxS.step
12.8 x 11.1 x 9.00 mm
