MitchellStride/Libraries/KiCAD/µ104_Part_Libs/KiCAD_3D_Parts/µ104KiCAD_IC_3D/SOIC-14_NARROW.step

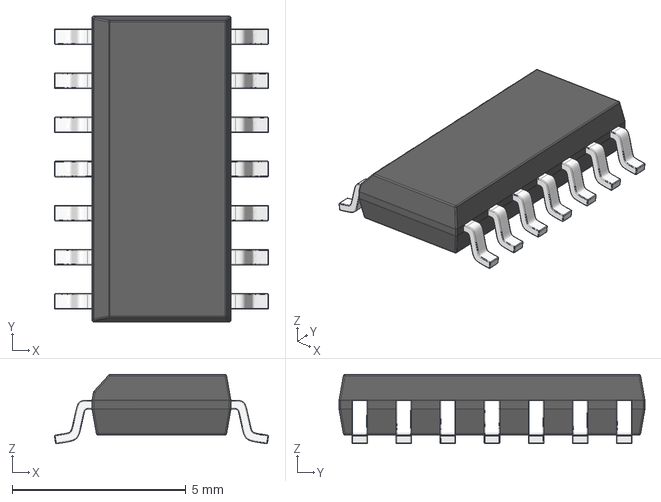
[picture p57: CAD file, 2018-05-30, last stored version]
KiCAD/µ104_Part_Libs/KiCAD_3D_Parts/µ104KiCAD_IC_3D/SOIC-14_NARROW.step
6.16 x 8.81 x 2.00 mm
