MitchellStride/Libraries/KiCAD/µ104_Part_Libs/KiCAD_3D_Parts/µ104KiCAD_RLC_3D/C_EPCOS-TDK_B32653_L26.5_W8.5_H16.5.step

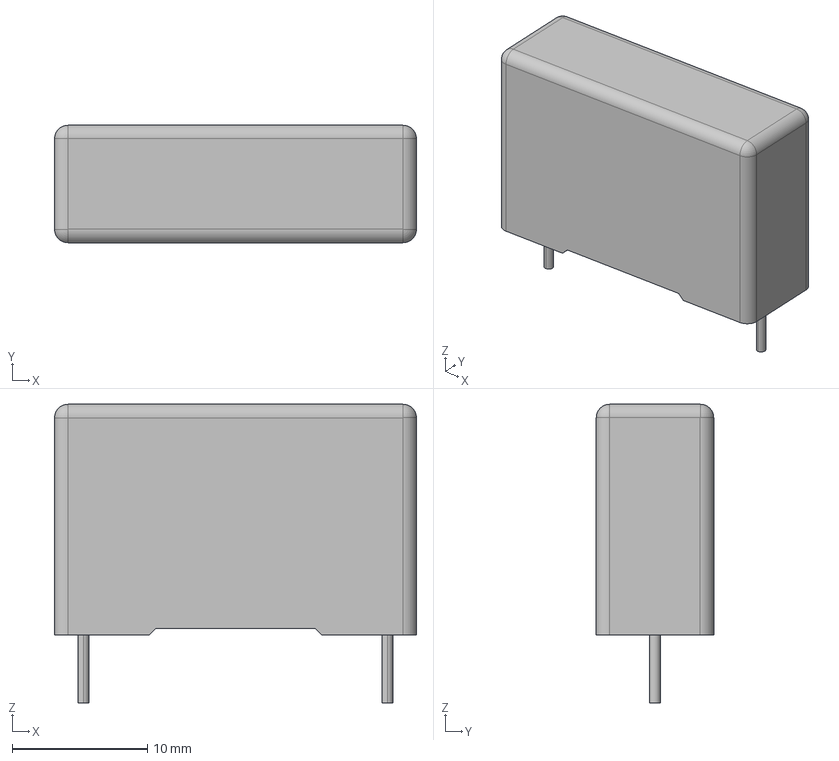
[picture p58: CAD file, 2018-05-30, last stored version]
KiCAD/µ104_Part_Libs/KiCAD_3D_Parts/µ104KiCAD_RLC_3D/C_EPCOS-TDK_B32653_L26.5_W8.5_H16.5.step
26.8 x 8.70 x 22.1 mm
