MitchellStride/Libraries/KiCAD/µ104_Part_Libs/KiCAD_3D_Parts/µ104KiCAD_connectors_3D/Samtec_TLW-106-05-G-S.step

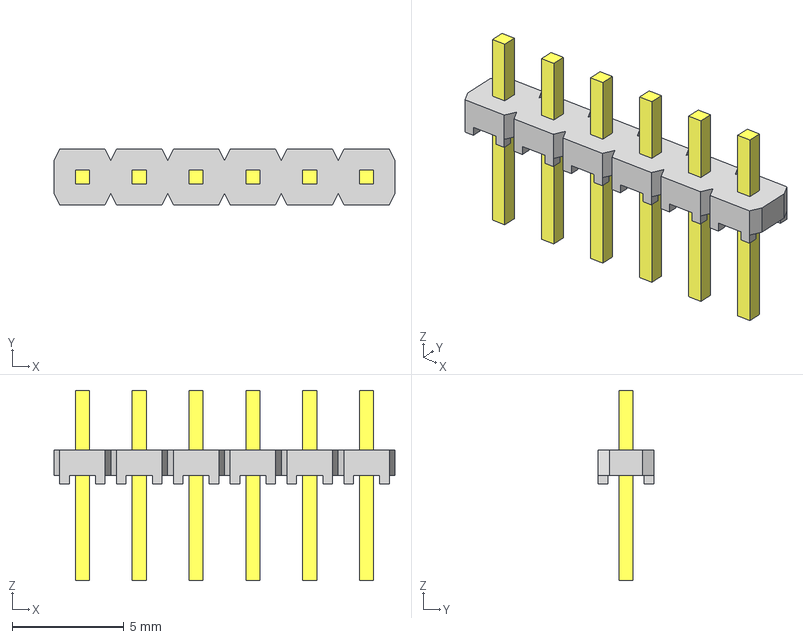
[picture p60: CAD file, 2018-05-30, last stored version]
KiCAD/µ104_Part_Libs/KiCAD_3D_Parts/µ104KiCAD_connectors_3D/Samtec_TLW-106-05-G-S.step
15.2 x 2.49 x 8.51 mm
