MitchellStride/Libraries/KiCAD/µ104_Part_Libs/KiCAD_3D_Parts/µ104KiCAD_DCDC_3D/GE-CriticalPower_ProLynx-APXW003.step

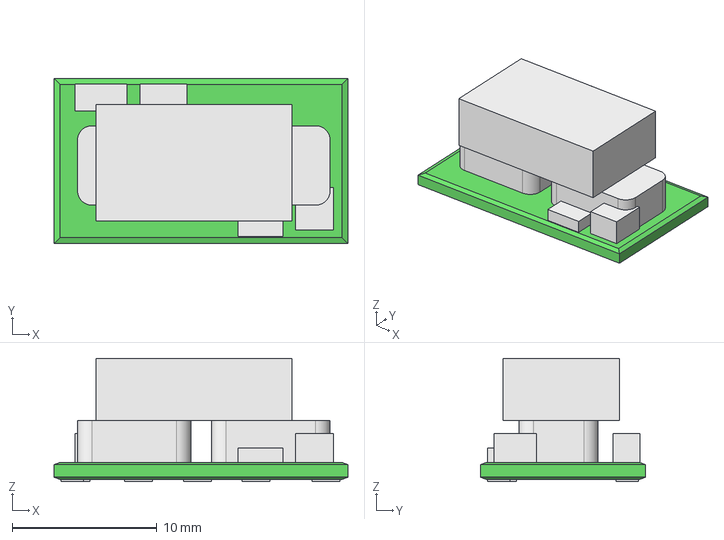
[picture p61: CAD file, 2018-05-30, last stored version]
KiCAD/µ104_Part_Libs/KiCAD_3D_Parts/µ104KiCAD_DCDC_3D/GE-CriticalPower_ProLynx-APXW003.step
20.3 x 11.4 x 8.51 mm
