MitchellStride/Libraries/KiCAD/µ104_Part_Libs/KiCAD_3D_Parts/µ104KiCAD_RLC_3D/C_Panasonic_AEC-Q200-FK_D8_H10.5.step

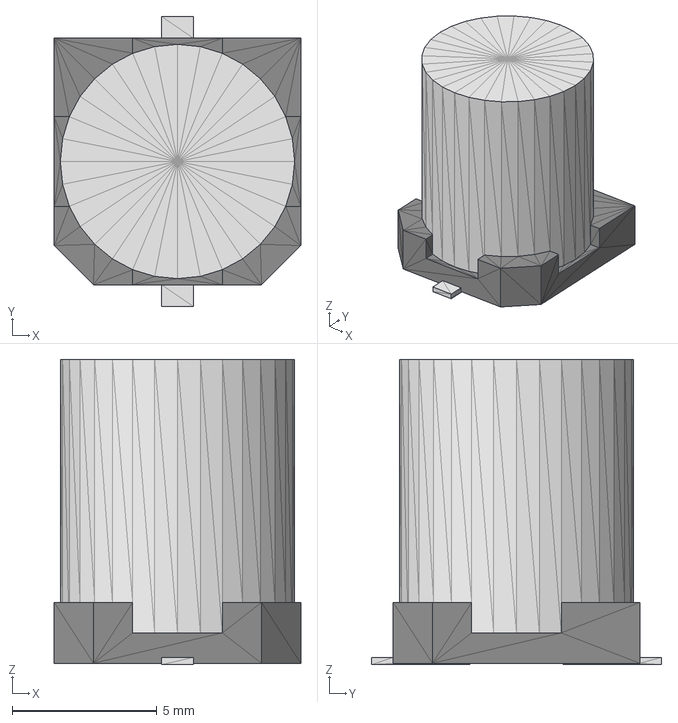
[picture p63: CAD file, 2018-05-30, last stored version]
KiCAD/µ104_Part_Libs/KiCAD_3D_Parts/µ104KiCAD_RLC_3D/C_Panasonic_AEC-Q200-FK_D8_H10.5.step
8.51 x 10.0 x 10.5 mm
