MitchellStride/Libraries/KiCAD/µ104_Part_Libs/KiCAD_3D_Parts/µ104KiCAD_connectors_3D/Molex_Micro-Fit3_0-43045-0200.step

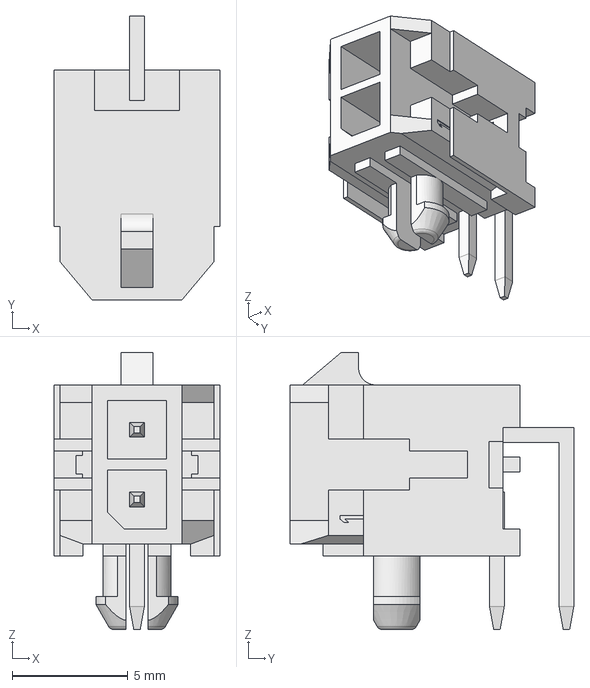
[picture p64: CAD file, 2018-05-30, last stored version]
KiCAD/µ104_Part_Libs/KiCAD_3D_Parts/µ104KiCAD_connectors_3D/Molex_Micro-Fit3_0-43045-0200.step
7.15 x 12.2 x 11.9 mm
