MitchellStride/Libraries/KiCAD/µ104_Part_Libs/KiCAD_3D_Parts/µ104KiCAD_DCDC_3D/GE-CriticalPower_FILTER_FLT007A0-SR.step

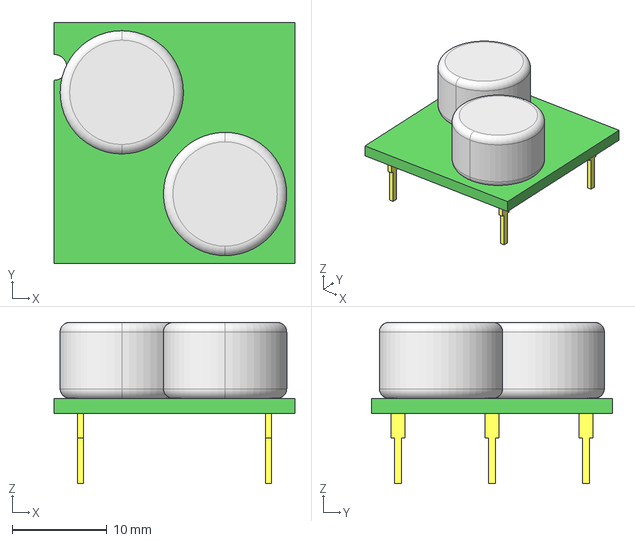
[picture p65: CAD file, 2018-05-30, last stored version]
KiCAD/µ104_Part_Libs/KiCAD_3D_Parts/µ104KiCAD_DCDC_3D/GE-CriticalPower_FILTER_FLT007A0-SR.step
25.4 x 25.4 x 17.0 mm
