MitchellStride/Libraries/KiCAD/µ104_Part_Libs/KiCAD_3D_Parts/µ104KiCAD_RLC_3D/C_Wurth_WCAP-ATG5_D10_H20.STEP

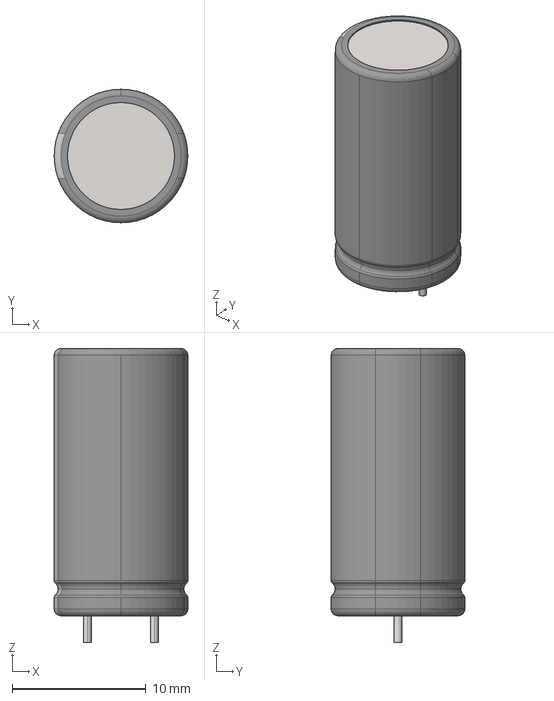
[picture p67: CAD file, 2018-05-30, last stored version]
KiCAD/µ104_Part_Libs/KiCAD_3D_Parts/µ104KiCAD_RLC_3D/C_Wurth_WCAP-ATG5_D10_H20.STEP
10.0 x 10.0 x 22.0 mm
