MitchellStride/Libraries/KiCAD/µ104_Part_Libs/KiCAD_3D_Parts/µ104KiCAD_DCDC_3D/Recom_INNOLINE-R-78HBxx_RA.STEP

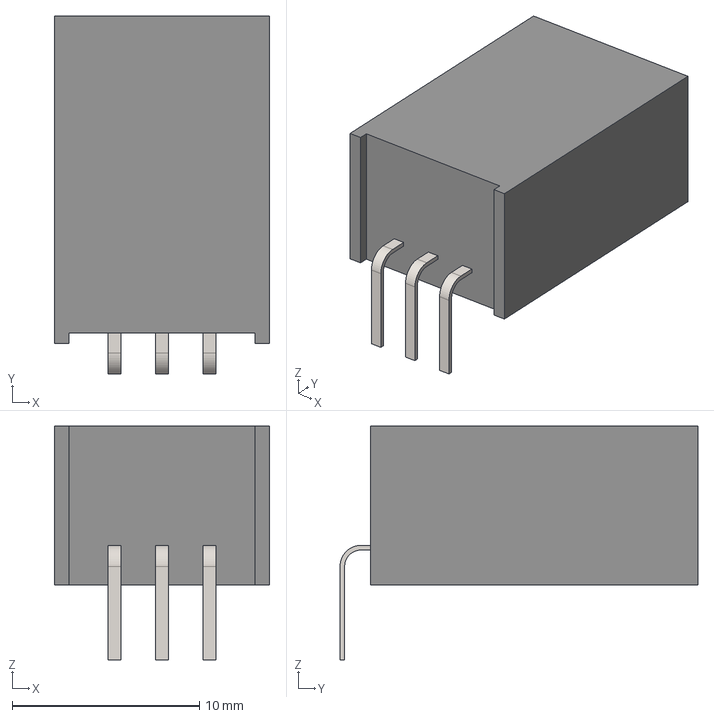
[picture p69: CAD file, 2018-05-30, last stored version]
KiCAD/µ104_Part_Libs/KiCAD_3D_Parts/µ104KiCAD_DCDC_3D/Recom_INNOLINE-R-78HBxx_RA.STEP
11.5 x 19.1 x 12.5 mm
