MitchellStride/Libraries/KiCAD/µ104_Part_Libs/KiCAD_3D_Parts/µ104KiCAD_RLC_3D/L_AbraconLLC_ASPI-1040HI.STEP

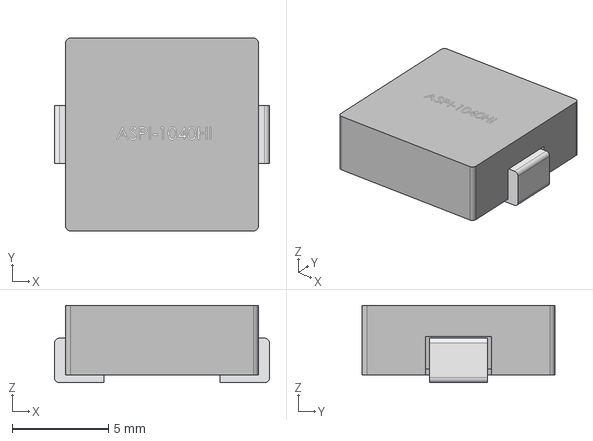
[picture p74: CAD file, 2018-05-30, last stored version]
KiCAD/µ104_Part_Libs/KiCAD_3D_Parts/µ104KiCAD_RLC_3D/L_AbraconLLC_ASPI-1040HI.STEP
11.2 x 10.0 x 4.00 mm
