MitchellStride/Libraries/KiCAD/µ104_Part_Libs/KiCAD_3D_Parts/µ104KiCAD_connectors_3D/Molex_Micro-Fit3_0-43650-0200.step

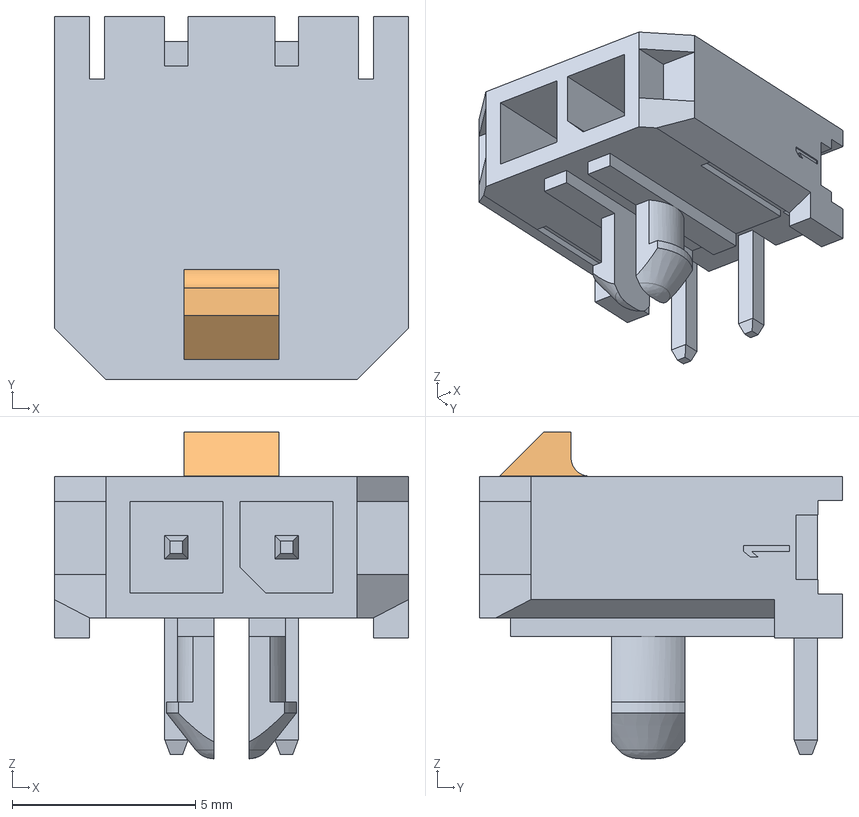
[picture p75: CAD file, 2018-05-30, last stored version]
KiCAD/µ104_Part_Libs/KiCAD_3D_Parts/µ104KiCAD_connectors_3D/Molex_Micro-Fit3_0-43650-0200.step
9.65 x 9.90 x 8.91 mm
