MitchellStride/Libraries/KiCAD/µ104_Part_Libs/KiCAD_3D_Parts/µ104KiCAD_DCDC_3D/XP-Power_JCK_6-DIP.STEP

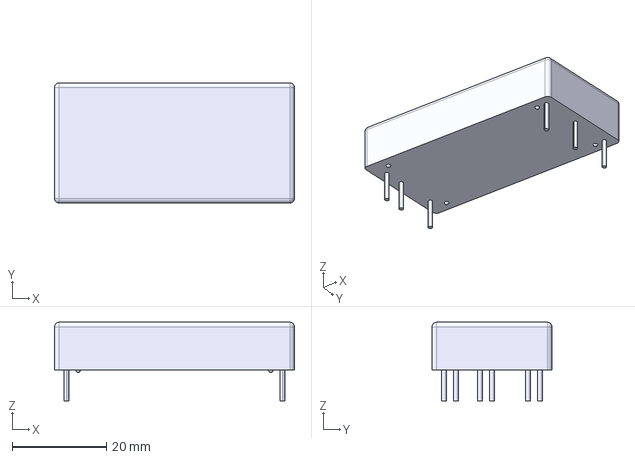
[picture p76: CAD file, 2018-05-30, last stored version]
KiCAD/µ104_Part_Libs/KiCAD_3D_Parts/µ104KiCAD_DCDC_3D/XP-Power_JCK_6-DIP.STEP
50.8 x 25.4 x 16.7 mm
