MitchellStride/Libraries/KiCAD/µ104_Part_Libs/KiCAD_3D_Parts/µ104KiCAD_connectors_3D/Molex_Micro-Fit3_0-43650-0312.step

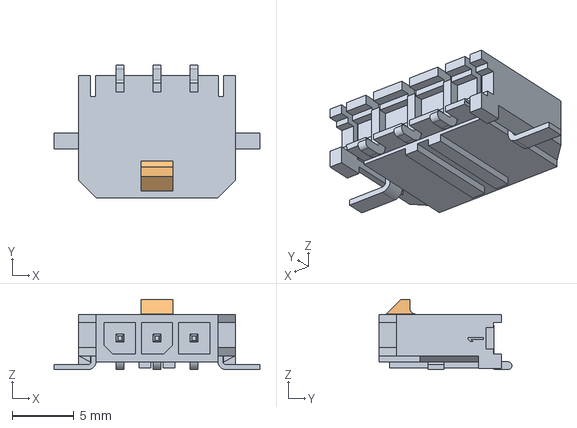
[picture p79: CAD file, 2018-05-30, last stored version]
KiCAD/µ104_Part_Libs/KiCAD_3D_Parts/µ104KiCAD_connectors_3D/Molex_Micro-Fit3_0-43650-0312.step
16.6 x 10.7 x 5.68 mm
