MitchellStride/Libraries/KiCAD/µ104_Part_Libs/KiCAD_3D_Parts/µ104KiCAD_DCDC_3D/Recom_INNOLINE-ROF-78E.step

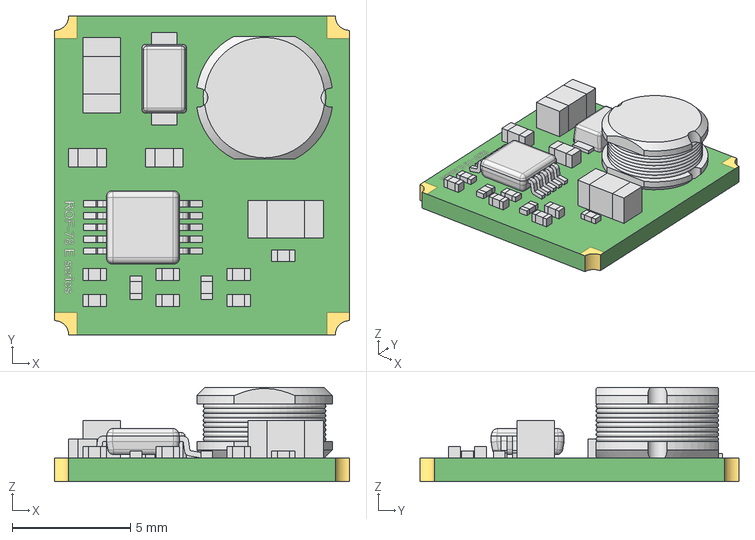
[picture p80: CAD file, 2018-05-30, last stored version]
KiCAD/µ104_Part_Libs/KiCAD_3D_Parts/µ104KiCAD_DCDC_3D/Recom_INNOLINE-ROF-78E.step
12.5 x 13.5 x 4.00 mm
