MitchellStride/Libraries/KiCAD/µ104_Part_Libs/KiCAD_3D_Parts/µ104KiCAD_RLC_3D/C_Murata_DECB33J471KC4B.step

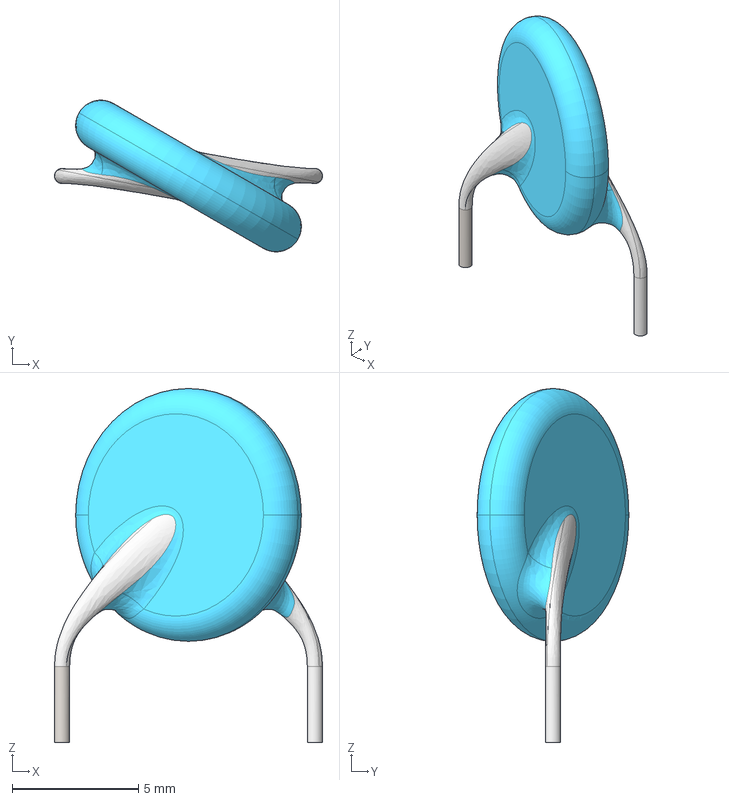
[picture p82: CAD file, 2018-05-30, last stored version]
KiCAD/µ104_Part_Libs/KiCAD_3D_Parts/µ104KiCAD_RLC_3D/C_Murata_DECB33J471KC4B.step
10.6 x 6.00 x 14.0 mm
