MitchellStride/Libraries/KiCAD/µ104_Part_Libs/KiCAD_3D_Parts/µ104KiCAD_RLC_3D/L_Bourns_2100LL.stp

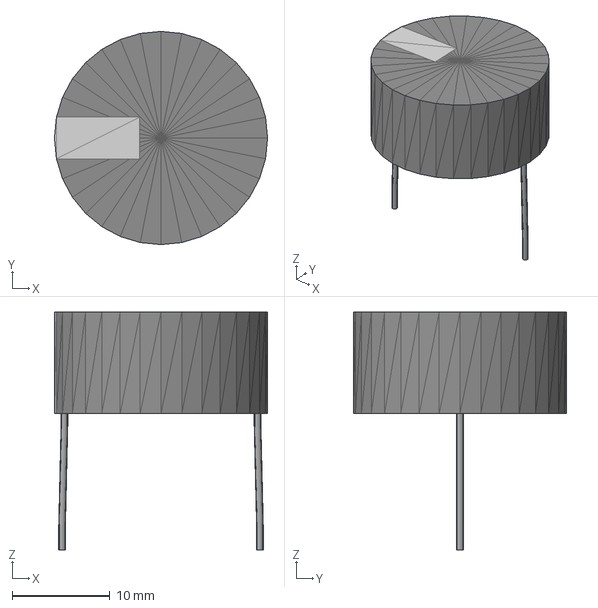
[picture p86: CAD file, 2018-05-30, last stored version]
KiCAD/µ104_Part_Libs/KiCAD_3D_Parts/µ104KiCAD_RLC_3D/L_Bourns_2100LL.stp
21.8 x 21.8 x 24.4 mm
