MitchellStride/Libraries/KiCAD/µ104_Part_Libs/KiCAD_3D_Parts/µ104KiCAD_DCDC_3D/Recom_INNOLINE-R-78E.step

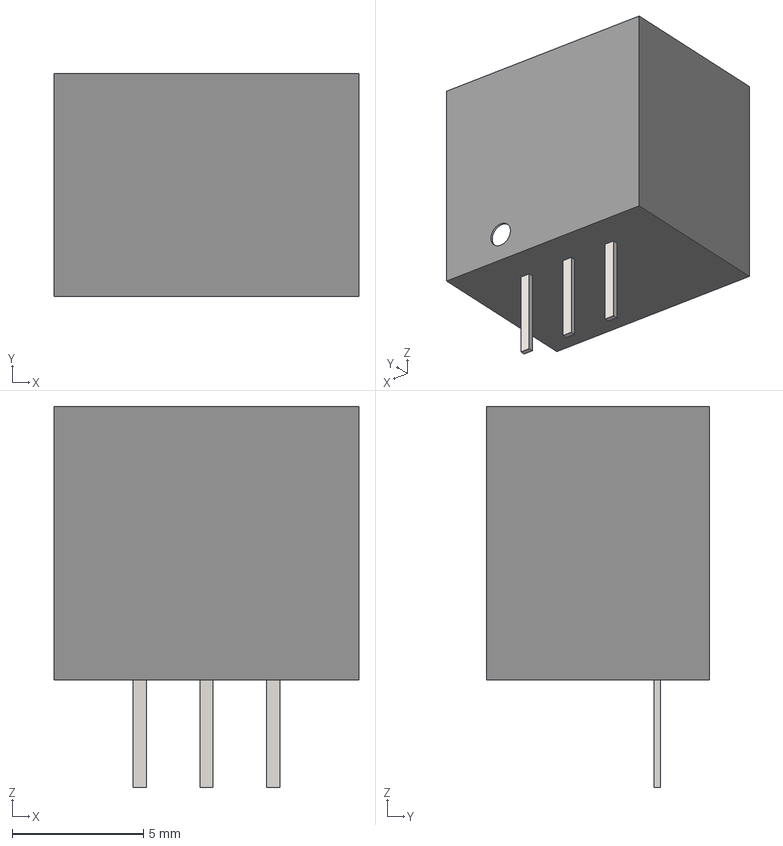
[picture p88: CAD file, 2018-05-30, last stored version]
KiCAD/µ104_Part_Libs/KiCAD_3D_Parts/µ104KiCAD_DCDC_3D/Recom_INNOLINE-R-78E.step
11.6 x 8.50 x 14.5 mm
