MitchellStride/Libraries/KiCAD/µ104_Part_Libs/KiCAD_3D_Parts/µ104KiCAD_IC_3D/Crystal_Abracon_ABS07.STEP

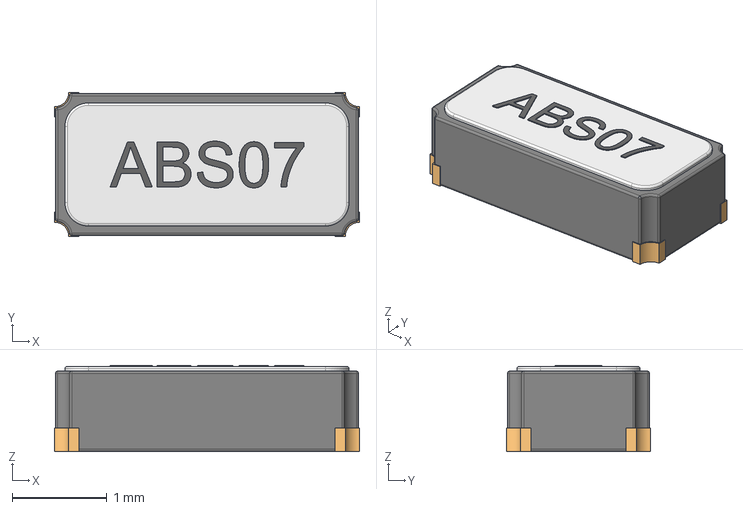
[picture p89: CAD file, 2018-05-30, last stored version]
KiCAD/µ104_Part_Libs/KiCAD_3D_Parts/µ104KiCAD_IC_3D/Crystal_Abracon_ABS07.STEP
3.22 x 1.52 x 0.91 mm
