MitchellStride/Libraries/KiCAD/µ104_Part_Libs/KiCAD_3D_Parts/µ104KiCAD_RLC_3D/C_Nichicon_UHE_D16_H15.STEP

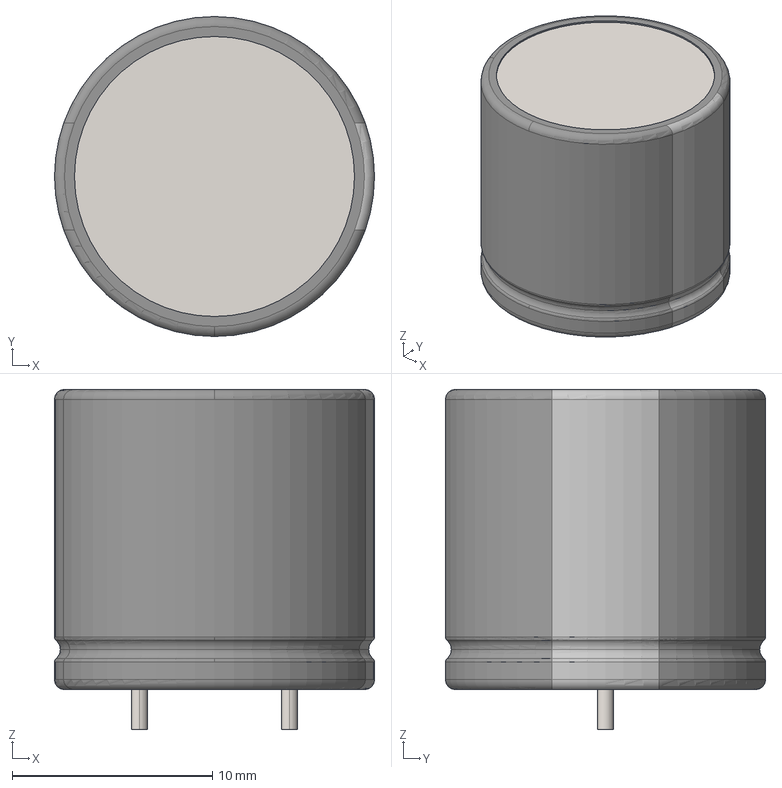
[picture p90: CAD file, 2018-05-30, last stored version]
KiCAD/µ104_Part_Libs/KiCAD_3D_Parts/µ104KiCAD_RLC_3D/C_Nichicon_UHE_D16_H15.STEP
16.0 x 16.0 x 17.0 mm
