MitchellStride/Libraries/KiCAD/µ104_Part_Libs/KiCAD_3D_Parts/µ104KiCAD_DCDC_3D/GE-CriticalPower_Hammerhead-EHHD006A0B.step

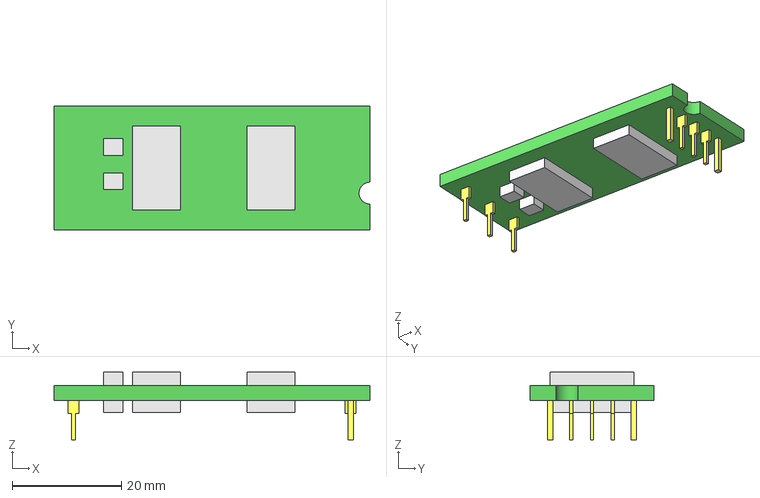
[picture p92: CAD file, 2018-05-30, last stored version]
KiCAD/µ104_Part_Libs/KiCAD_3D_Parts/µ104KiCAD_DCDC_3D/GE-CriticalPower_Hammerhead-EHHD006A0B.step
57.9 x 22.8 x 12.4 mm
