MitchellStride/Libraries/KiCAD/µ104_Part_Libs/KiCAD_3D_Parts/µ104KiCAD_IC_3D/SOT-363_SC-70-6.STEP

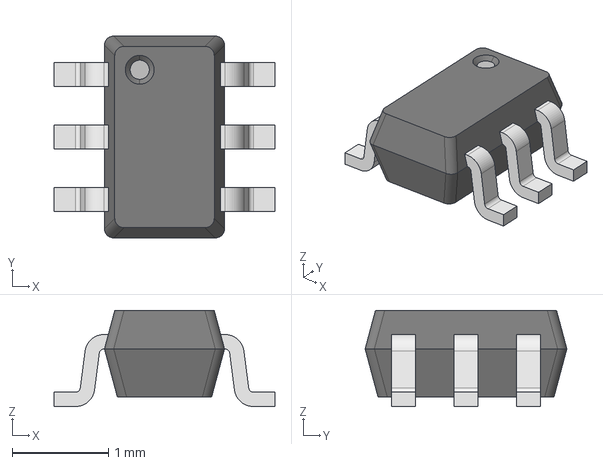
[picture p93: CAD file, 2018-05-30, last stored version]
KiCAD/µ104_Part_Libs/KiCAD_3D_Parts/µ104KiCAD_IC_3D/SOT-363_SC-70-6.STEP
2.30 x 2.10 x 1.00 mm
