MitchellStride/Libraries/KiCAD/µ104_Part_Libs/KiCAD_3D_Parts/µ104KiCAD_connectors_3D/Samtec_QSH-030-01-x-D-xx.step

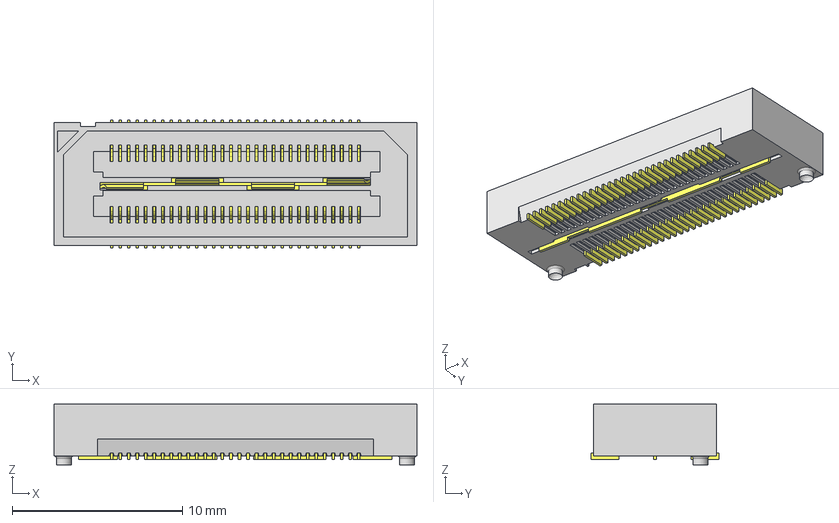
[picture p95: CAD file, 2018-05-30, last stored version]
KiCAD/µ104_Part_Libs/KiCAD_3D_Parts/µ104KiCAD_connectors_3D/Samtec_QSH-030-01-x-D-xx.step
21.3 x 7.49 x 3.56 mm
