MitchellStride/Libraries/KiCAD/µ104_Part_Libs/KiCAD_3D_Parts/µ104KiCAD_DCDC_3D/Recom_ECONOLINE-RSO.step

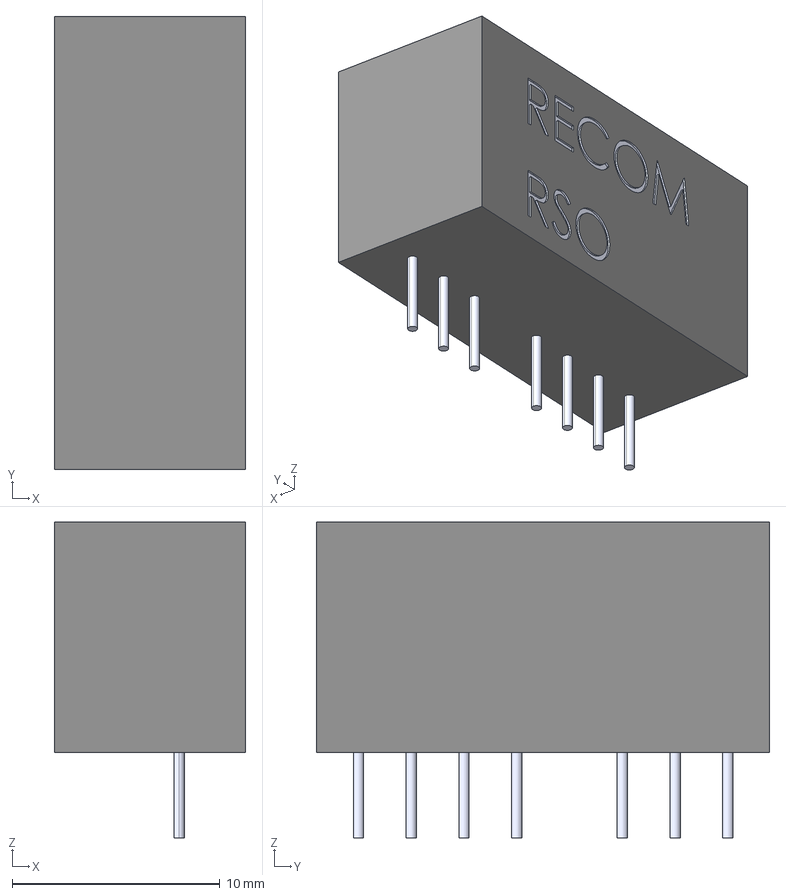
[picture p96: CAD file, 2018-05-30, last stored version]
KiCAD/µ104_Part_Libs/KiCAD_3D_Parts/µ104KiCAD_DCDC_3D/Recom_ECONOLINE-RSO.step
9.20 x 21.8 x 15.2 mm
