MitchellStride/Libraries/KiCAD/µ104_Part_Libs/KiCAD_3D_Parts/µ104KiCAD_RLC_3D/C_Panasonic_AEC-Q200-S_D5_H5.4.step

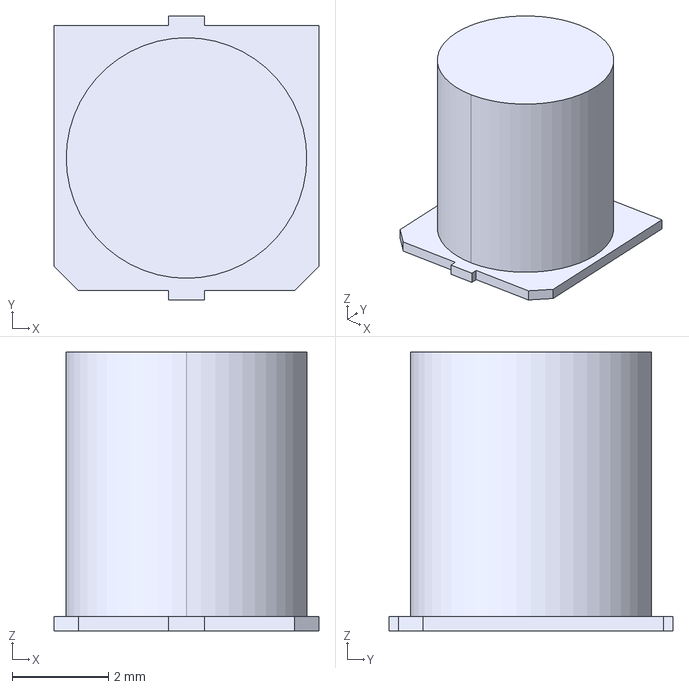
[picture p98: CAD file, 2018-05-30, last stored version]
KiCAD/µ104_Part_Libs/KiCAD_3D_Parts/µ104KiCAD_RLC_3D/C_Panasonic_AEC-Q200-S_D5_H5.4.step
5.50 x 5.90 x 5.80 mm
