MitchellStride/Libraries/KiCAD/µ104_Part_Libs/KiCAD_3D_Parts/µ104KiCAD_RLC_3D/POT_Copal_SM-42TA.step

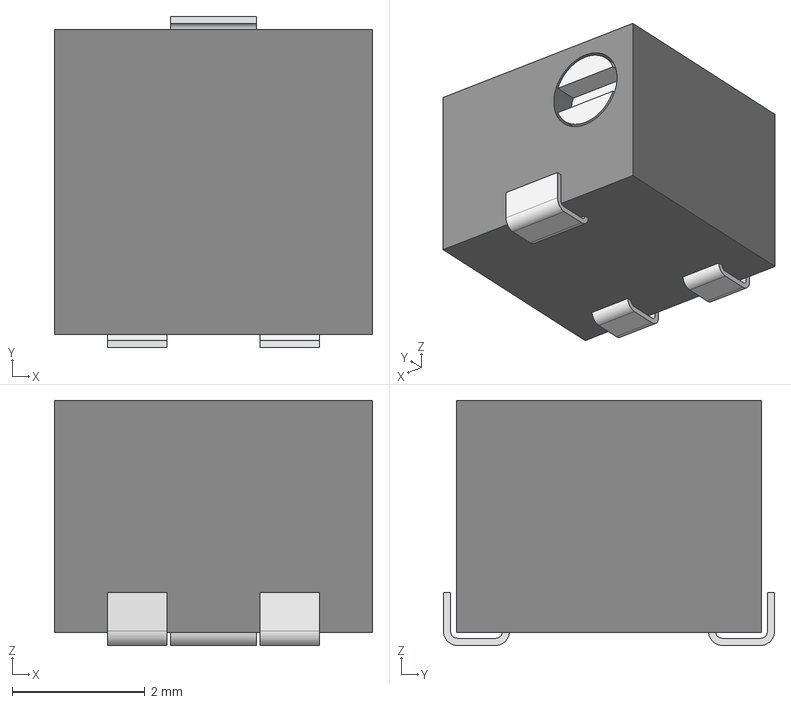
[picture p102: CAD file, 2018-05-30, last stored version]
KiCAD/µ104_Part_Libs/KiCAD_3D_Parts/µ104KiCAD_RLC_3D/POT_Copal_SM-42TA.step
4.80 x 5.00 x 3.70 mm
