MitchellStride/Libraries/KiCAD/µ104_Part_Libs/KiCAD_3D_Parts/µ104KiCAD_connectors_3D/HEADER_SMD_ST_1.27mm_02x01.step

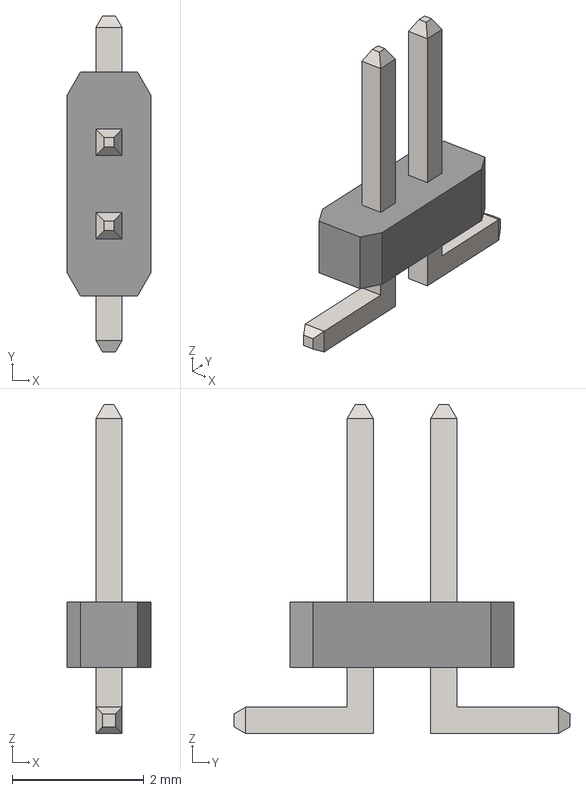
[picture p103: CAD file, 2018-05-30, last stored version]
KiCAD/µ104_Part_Libs/KiCAD_3D_Parts/µ104KiCAD_connectors_3D/HEADER_SMD_ST_1.27mm_02x01.step
1.27 x 5.10 x 5.00 mm
