MitchellStride/Libraries/KiCAD/µ104_Part_Libs/KiCAD_3D_Parts/µ104KiCAD_RLC_3D/C_Nichicon_URY_D12.5_H14.STEP

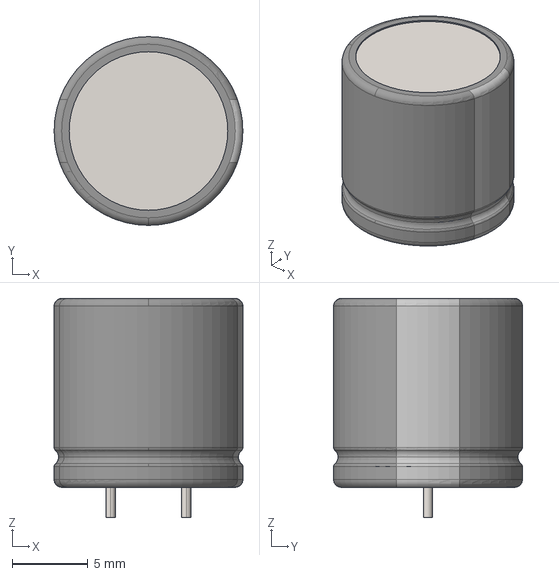
[picture p106: CAD file, 2018-05-30, last stored version]
KiCAD/µ104_Part_Libs/KiCAD_3D_Parts/µ104KiCAD_RLC_3D/C_Nichicon_URY_D12.5_H14.STEP
12.5 x 12.5 x 14.5 mm
