MitchellStride/Libraries/KiCAD/µ104_Part_Libs/KiCAD_3D_Parts/µ104KiCAD_IC_3D/LEDdriver_LEDdynamics_BuckPuck3021.step

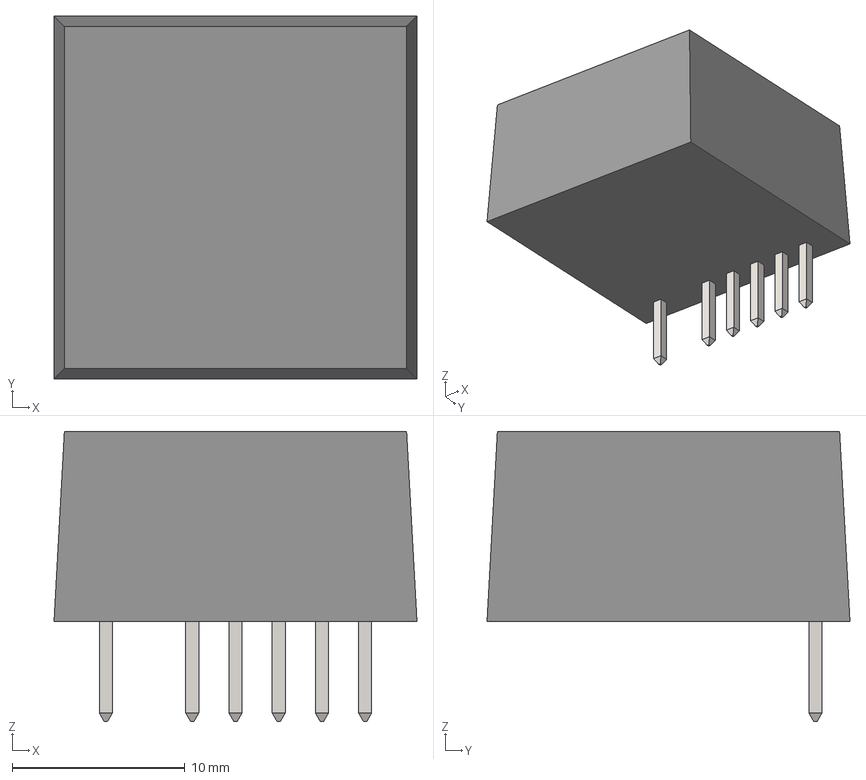
[picture p111: CAD file, 2018-05-30, last stored version]
KiCAD/µ104_Part_Libs/KiCAD_3D_Parts/µ104KiCAD_IC_3D/LEDdriver_LEDdynamics_BuckPuck3021.step
21.0 x 21.0 x 16.8 mm
