MitchellStride/Libraries/KiCAD/µ104_Part_Libs/KiCAD_3D_Parts/µ104KiCAD_connectors_3D/HEADER_SMD_ST_1.27mm_01x03.step

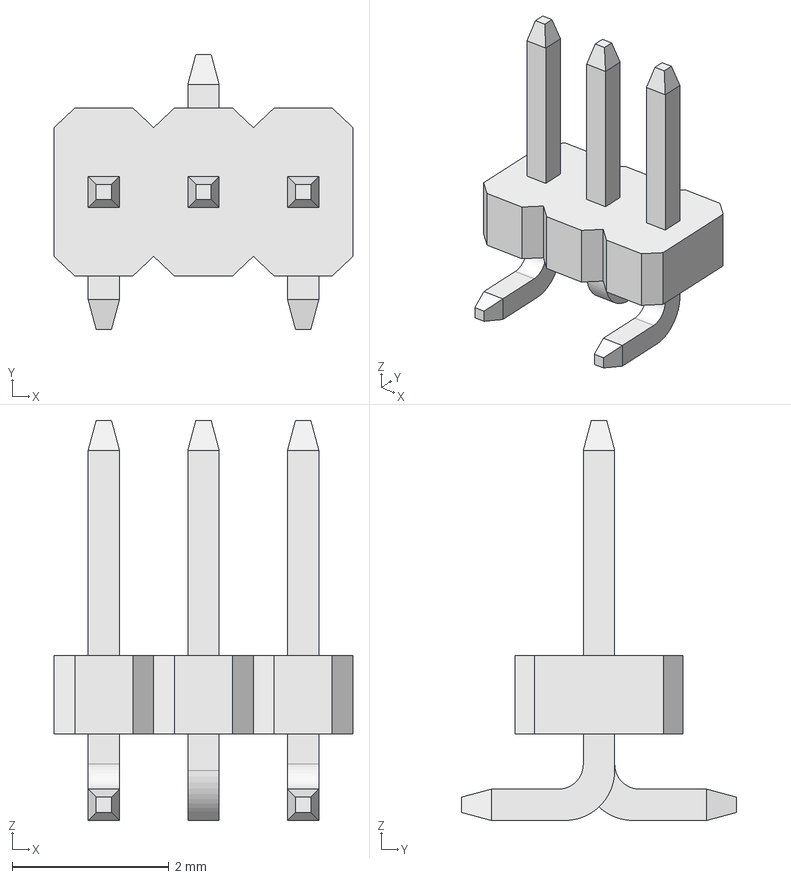
[picture p112: CAD file, 2018-05-30, last stored version]
KiCAD/µ104_Part_Libs/KiCAD_3D_Parts/µ104KiCAD_connectors_3D/HEADER_SMD_ST_1.27mm_01x03.step
3.81 x 3.50 x 5.10 mm
