MitchellStride/Libraries/KiCAD/µ104_Part_Libs/KiCAD_3D_Parts/µ104KiCAD_connectors_3D/HEADER_SMD_ST_1.27mm_02x02.step

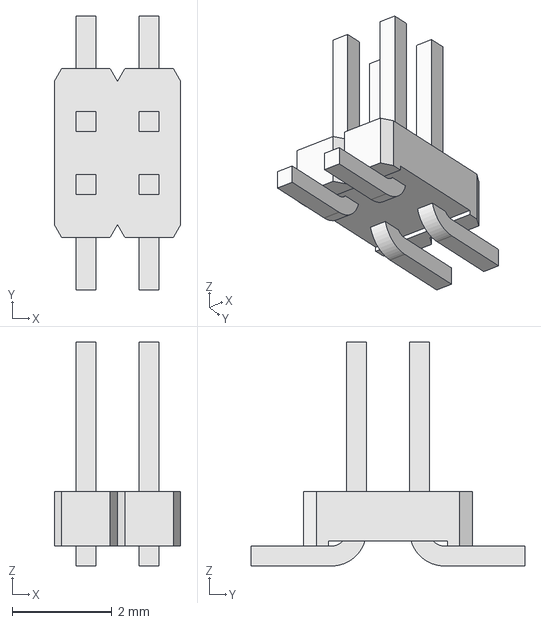
[picture p114: CAD file, 2018-05-30, last stored version]
KiCAD/µ104_Part_Libs/KiCAD_3D_Parts/µ104KiCAD_connectors_3D/HEADER_SMD_ST_1.27mm_02x02.step
2.54 x 5.50 x 4.50 mm
