MitchellStride/Libraries/KiCAD/µ104_Part_Libs/KiCAD_3D_Parts/µ104KiCAD_IC_3D/EnviroSensor_TE-Connectivity_MS8607-02BA01.STEP

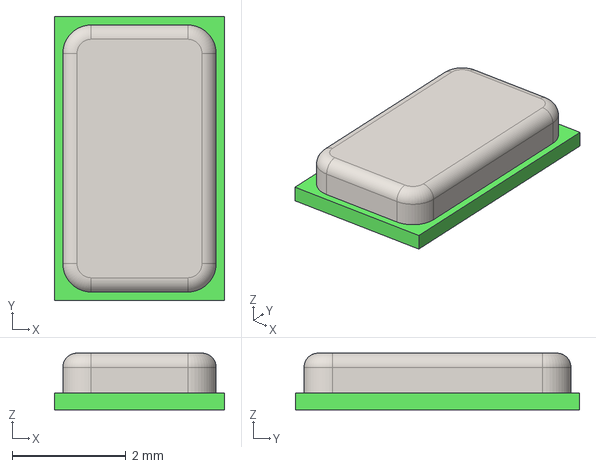
[picture p115: CAD file, 2018-05-30, last stored version]
KiCAD/µ104_Part_Libs/KiCAD_3D_Parts/µ104KiCAD_IC_3D/EnviroSensor_TE-Connectivity_MS8607-02BA01.STEP
3.00 x 5.00 x 1.00 mm
