MitchellStride/Libraries/KiCAD/µ104_Part_Libs/KiCAD_3D_Parts/µ104KiCAD_RLC_3D/L_Murata_1415440C.STEP

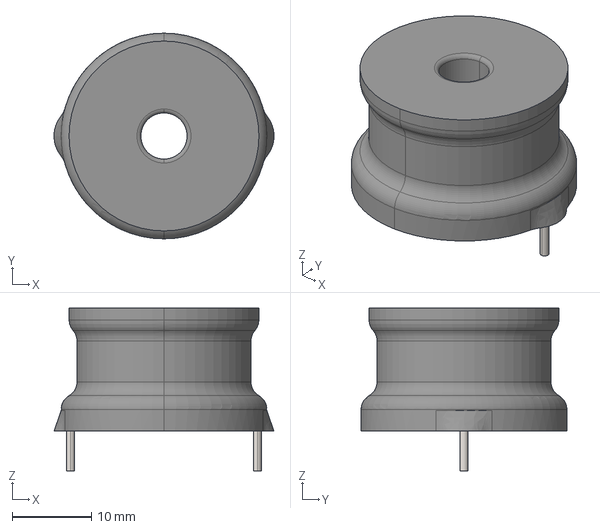
[picture p116: CAD file, 2018-05-30, last stored version]
KiCAD/µ104_Part_Libs/KiCAD_3D_Parts/µ104KiCAD_RLC_3D/L_Murata_1415440C.STEP
27.7 x 25.9 x 20.5 mm
