MitchellStride/Libraries/KiCAD/µ104_Part_Libs/KiCAD_3D_Parts/µ104KiCAD_IC_3D/Optoisolator_Lite-OnInc_LTV-352T.STEP

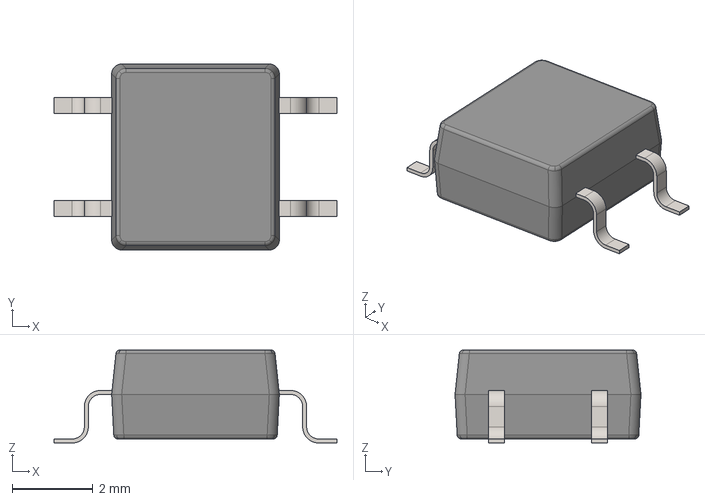
[picture p118: CAD file, 2018-05-30, last stored version]
KiCAD/µ104_Part_Libs/KiCAD_3D_Parts/µ104KiCAD_IC_3D/Optoisolator_Lite-OnInc_LTV-352T.STEP
7.00 x 4.60 x 2.30 mm
