MitchellStride/Libraries/KiCAD/µ104_Part_Libs/KiCAD_3D_Parts/µ104KiCAD_RLC_3D/L_Wurth_WE-PD_L12_W12_H8.step

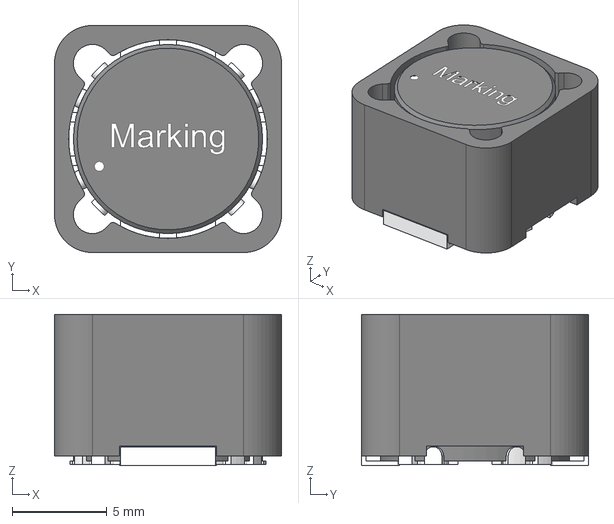
[picture p119: CAD file, 2018-05-30, last stored version]
KiCAD/µ104_Part_Libs/KiCAD_3D_Parts/µ104KiCAD_RLC_3D/L_Wurth_WE-PD_L12_W12_H8.step
12.0 x 12.0 x 8.00 mm
