MitchellStride/Libraries/KiCAD/µ104_Part_Libs/KiCAD_3D_Parts/µ104KiCAD_RLC_3D/POT_Copal_SM-42TW.STEP

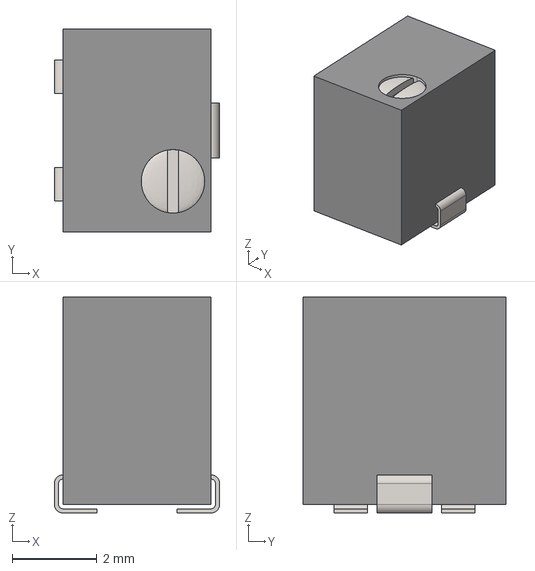
[picture p122: CAD file, 2018-05-30, last stored version]
KiCAD/µ104_Part_Libs/KiCAD_3D_Parts/µ104KiCAD_RLC_3D/POT_Copal_SM-42TW.STEP
3.90 x 4.80 x 5.10 mm
