MitchellStride/Libraries/KiCAD/µ104_Part_Libs/KiCAD_3D_Parts/µ104KiCAD_IC_3D/LQFP-32_7x7mm_Pitch0.8mm.step

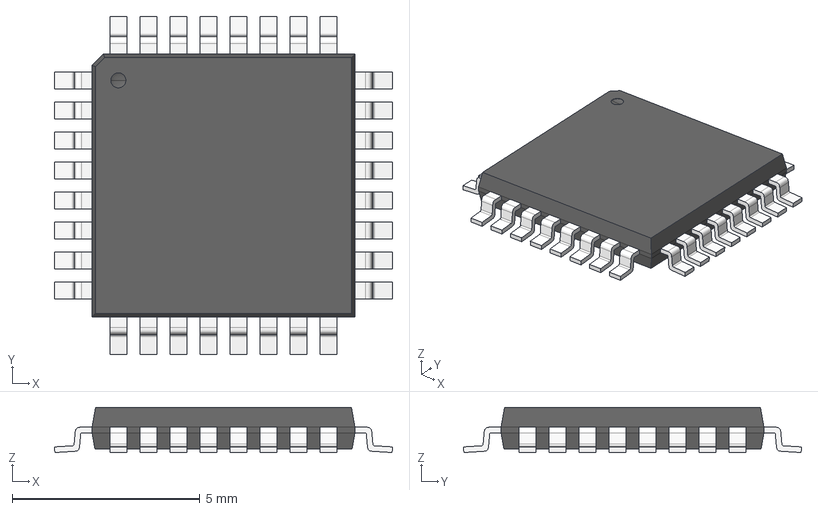
[picture p124: CAD file, 2018-05-30, last stored version]
KiCAD/µ104_Part_Libs/KiCAD_3D_Parts/µ104KiCAD_IC_3D/LQFP-32_7x7mm_Pitch0.8mm.step
9.00 x 9.00 x 1.20 mm
