MitchellStride/Libraries/KiCAD/µ104_Part_Libs/KiCAD_3D_Parts/µ104KiCAD_RLC_3D/L_Bourns_2100LL-H_P0.76.step

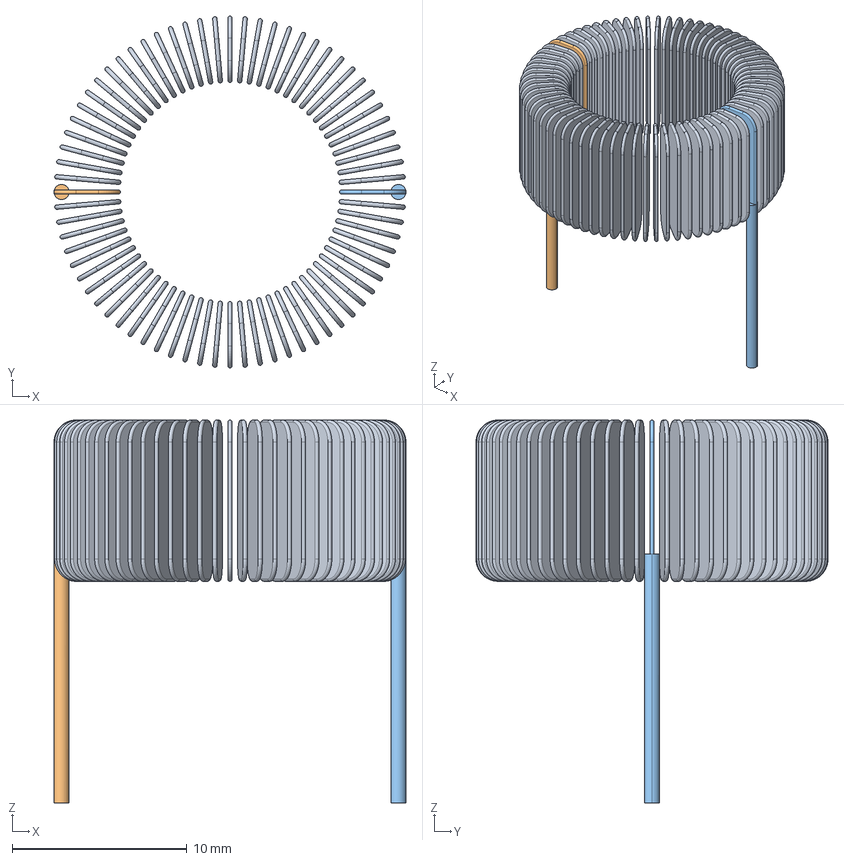
[picture p125: CAD file, 2018-05-30, last stored version]
KiCAD/µ104_Part_Libs/KiCAD_3D_Parts/µ104KiCAD_RLC_3D/L_Bourns_2100LL-H_P0.76.step
20.2 x 20.2 x 21.9 mm
