MitchellStride/Libraries/KiCAD/µ104_Part_Libs/KiCAD_3D_Parts/µ104KiCAD_RLC_3D/C_Nichicon_UBY_D12.5_H21.5_negL.step

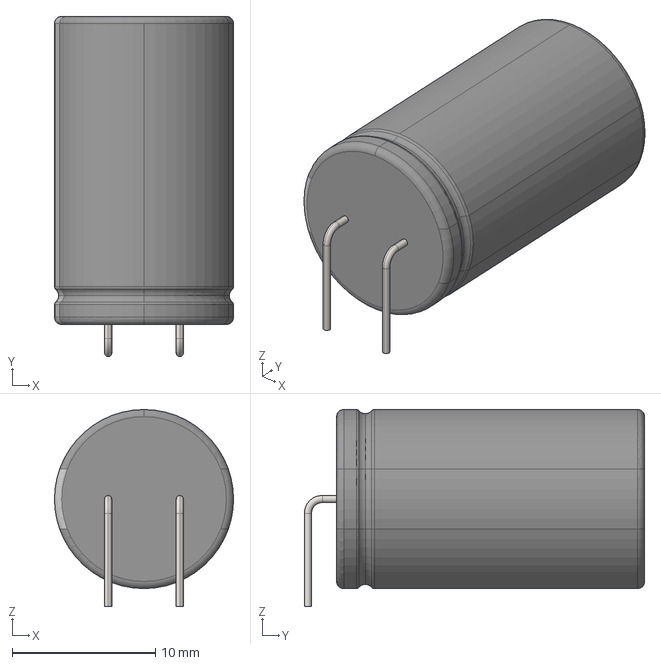
[picture p127: CAD file, 2018-05-30, last stored version]
KiCAD/µ104_Part_Libs/KiCAD_3D_Parts/µ104KiCAD_RLC_3D/C_Nichicon_UBY_D12.5_H21.5_negL.step
12.5 x 23.8 x 13.8 mm
