MitchellStride/Libraries/KiCAD/µ104_Part_Libs/KiCAD_3D_Parts/µ104KiCAD_RLC_3D/L_Wurth_WE-HCM_L14_W13_H9.5.step

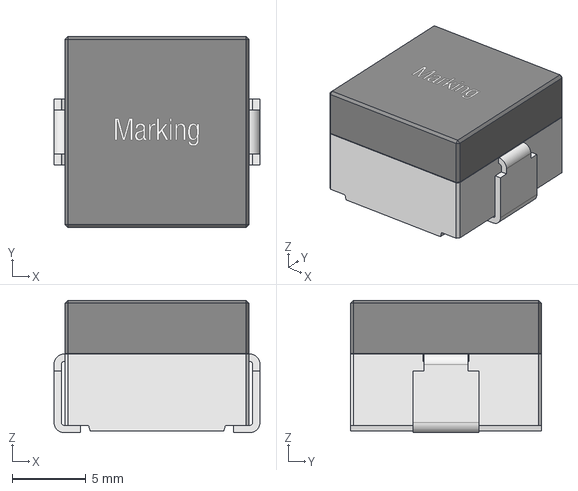
[picture p132: CAD file, 2018-05-30, last stored version]
KiCAD/µ104_Part_Libs/KiCAD_3D_Parts/µ104KiCAD_RLC_3D/L_Wurth_WE-HCM_L14_W13_H9.5.step
14.0 x 13.0 x 9.00 mm
