MitchellStride/Libraries/KiCAD/µ104_Part_Libs/KiCAD_3D_Parts/µ104KiCAD_RLC_3D/L_AbraconLLC_AIRD-03.STEP

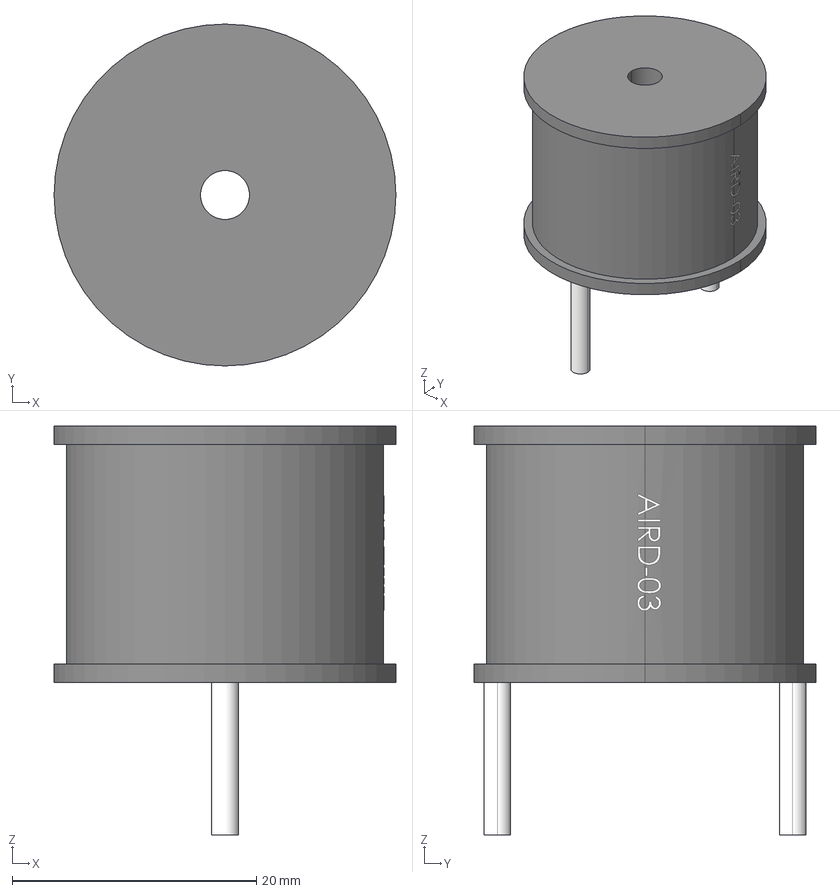
[picture p135: CAD file, 2018-05-30, last stored version]
KiCAD/µ104_Part_Libs/KiCAD_3D_Parts/µ104KiCAD_RLC_3D/L_AbraconLLC_AIRD-03.STEP
28.0 x 28.0 x 33.5 mm
