MitchellStride/Libraries/KiCAD/µ104_Part_Libs/KiCAD_3D_Parts/µ104KiCAD_RLC_3D/F_Bussmann_PC-Tron.step

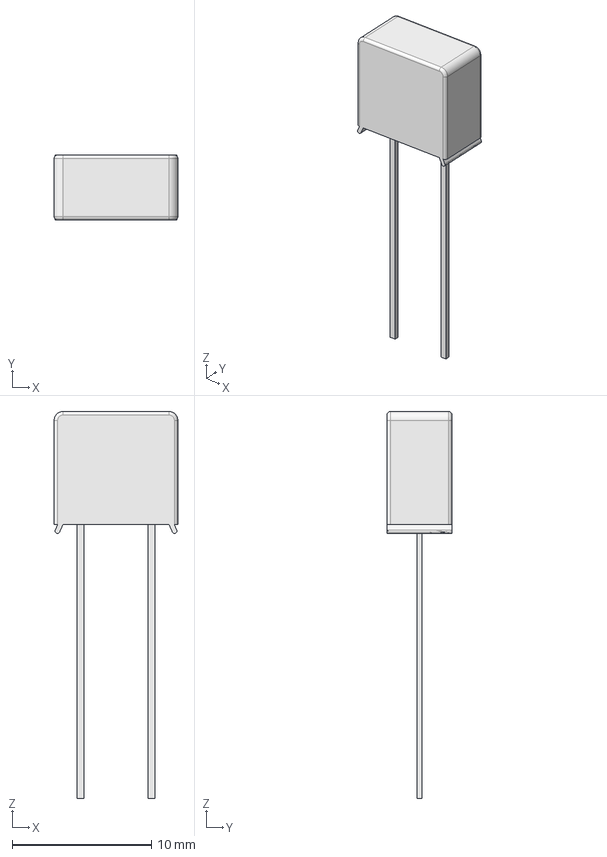
[picture p138: CAD file, 2018-05-30, last stored version]
KiCAD/µ104_Part_Libs/KiCAD_3D_Parts/µ104KiCAD_RLC_3D/F_Bussmann_PC-Tron.step
8.89 x 4.67 x 27.8 mm
