MitchellStride/Libraries/(list of files, drawings)

Other design files:
Altium/u104Systems.PcbLib
Altium/u104Systems.SchLib
