MitchellStride/Libraries/(commit log)

2018-01-16 KiCad footprints Jan2018
2018-02-08 started schematic
2018-03-30 push kicad
2018-05-30 created u104 libs
    [CAP0402.stp, CAP0603.stp, CAP0805.stp, CAP1206.stp, CAP1210.step, CAP1210.stp, CAP1812.stp, CAP1825.stp]
2018-07-05 deleted outdated libs
    [u104Systems.PcbLib, u104Systems.SchLib]
2019-11-22 alienware push
    [X2SON-4_1x1mm_P0.65mm.fcstd, sod-70.fcstd, sod-70_P5.08mm.fcstd]
2023-04-19 cleaned up libs
    [u104Systems.PcbLib, u104Systems.SchLib]
2023-06-19 removed old stuff
    [CAP0402.stp, CAP0603.stp, CAP0805.stp, CAP1206.stp, CAP1210.step, CAP1210.stp, CAP1812.stp, CAP1825.stp]
